im-pro-at/DIYsmarthome/README.md

# DIYsmarthome
Cheap DIY smart home system

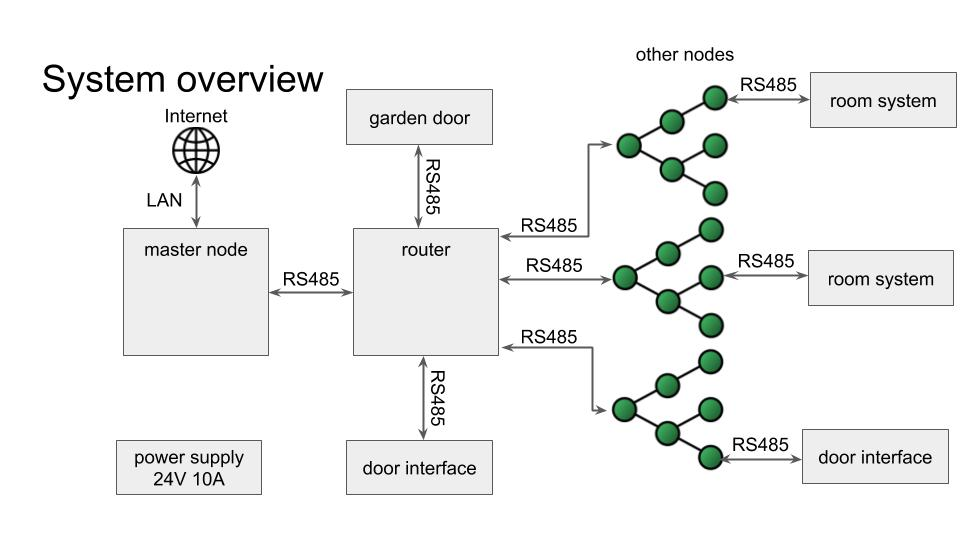
[picture p1: images/system_overview.jpg]
System overview
