im-pro-at/DIYsmarthome/PCB/room/ESP32_PINMAP.md

| PIN WROVER | GPIO | NODE | ESP32 FUNCTION | OV2640 | MAX14830 | WM8974 | I2C  |
| --- | ---- | --- | --- | --- | --- | --- | ---- |
| 25 | 0 | BOOT MODE | BOOT MODE | | | | SDC  |
| 35 | 1 | OUTPUT AT BOOT | U0TX | | | DACDAT | |
| 24 | 2 | LOW BOOT | | SIOC | | | |
| 34 | 3 | OUTPUT AT BOOT | U0RX | | | BCLK | |
| 26 | 4 | | | | | FRAME  | |
| 29 | 5 | OUTPUT AT BOOT | | | CS | | |
| 20 | 6 | FLSCH | SCK | | | | |
| 21 | 7 | FLSCH | SDO | | | | |
| 22 | 8 | FLSCH | SDI | | | | |
| 17 | 9 | FLSCH | SD2 | | | | |
| 18 | 10 | FLSCH | SD3 | | | | |
| 19 | 11 | FLSCH | CMD | | | | |
| 14 | 12 | LOW BOOT | JTAG | Y3 | | | |
| 16 | 13 | | JTAG | Y4 | | | |
| 13 | 14 | OUTPUT AT BOOT | JTAG | Y2 | | | |
| 23 | 15 | OUTPUT AT BOOT | JTAG | Y5 | | | |
| 30 | 18 | | | | SCLK | | |
| 31 | 19 | | | | MISO | | |
| 33 | 21 | | | | IRQ | | |
| 36 | 22 | | | PCLK | | | |
| 37 | 23 | | | | MOSI | | |
| 10 | 25 | | | VSNC | | | |
| 11 | 26 | | | SIOD | | | |
| 12 | 27 | | | HREF | | | |
| 8 | 32 | | | | | ADCDAT | |
| 9 | 33 | | | | | | SDA  |
| 6 | 34 | INPUT | | Y6 | | | |
| 7 | 35 | INPUT | | Y7 | | | |
| 4 | 36 | INPUT | SENSOR_VP | Y9 | | | |
| 5 | 39 | INPUT | SENSOR_VN | Y8 | | | |
| 3 | | | EN | | | | |
| 1 | | | GND | | | | |
| 2 | | | 3V3 | | | | |
| 15 | | | GND | | | | |
| 27 | | | NC | | | | |
| 28 | | | NC | | | | |
| 32 | | | NC | | | | |
| 38 | | | GND | | | | |
