im-pro-at/DIYsmarthome/PCB/master/BOM.md

| # | Deschription | Mfr. Part | Supplier | Unit Cost | Total |
| :-: | --- | --- | --- | ---: | ----: |
| 1 | PCB | [JLCPCB](https://jlcpcb.com/quote) | jlcpcb | 2 | 2 |
| 1 | Raspberry Pi 3 Modell B+ | 1690-1000-ND | Digi-Key | 35.50  | 35.50 |
| 1 | Header 40 Pol | [DS1023-2*20SF11](<https://lcsc.com/search?q=DS1023-2*20SF11>) | Lcsc | 0.25 | 0.25 |
| 1 | SanDisk Ultra 16GB Class 10 | [SDSQUAR-016G](https://www.amazon.de/SanDisk-Ultra-microSDHC-Speicherkarte-Adapter/dp/B073S9SFK2/) | Amazon | 6.99  | 6.99 |
| 1 | SPI to UART | [MAX14830](https://octopart.com/search?q=MAX14830) | Digi-Key | 11.39 | 11.39 |
| 4 | RS485 | [SN65HVD11DR](https://octopart.com/search?q=SN65HVD11DR) | Lcsc, Digi-Key | 0.53 | 2.12 |
| 4 | ESD prodection | [CDSOT23-0502B](https://lcsc.com/product-detail/Diodes-ESD_Yenji-Elec-CDSOT23-0502B_C252429.html) |  |  |  |
| 1 | supply 2A | [LMR16020](https://octopart.com/search?q=LMR16020) | Lcsc, Digi-Key | 1.01 | 1.01 |
| 4 | terminal | [WJ500V-5.08-3P](https://octopart.com/search?q=WJ500V-5.08-3P) | Lcsc | 0.12 | 0.48 |
| 2 | 47uF 35V 5x5.8 | EEEFT1V470AR | Lcsc |  |  |
| 10 | 100nF 50V X7R 0805 | CL21B104KBCNNNC | Lcsc |  |  |
| 1 | Inductor 10uH 3.9A 39.6mOhm | 1217AS-H-100M=P3 |  |  |  |
| 4 | Res 120R 1206 |  |  |  |  |
| 1 | Res 12k 1206 |  |  |  |  |
| 8 | Res 1k 1206 |  |  |  |  |
| 2 | 1uF 16V X7R 0805 | CL21B105KOFNNNE |  |  |  |
| 2 | 2.2uF 50V X7R 1206 | CL31B225KBHNNNE |  |  |  |
| 1 | fuse | 40012000000 |  |  |  |
| 1 | Res 41.2k 1206 |  |  |  |  |
| 2 | 47uF 10V X5R 1210 | CL32A476MPJNNNE |  |  |  |
| 2 | Res 4.7k 1206 |  |  |  |  |
| 1 | Res 68k 1206 |  |  |  |  |
| 1 | Schottky 60V 3A SMB | B360B-13-F |  |  |  |
| 1 | Schottky 60V 2A SMB | B260-13-F |  |  |  |
| 1 | Varistor 320V 400A | B72205S0251K101 |  |  |  |
|  1 | Oscillator 12Mhz | X1G004171001800 | | | |
