im-pro-at/DIYsmarthome/PCB/room/BOM.md

| # | Deschription | Mfr. Part | Supplier | Unit Cost [€] | Total [€] |
| :-: | :--- | --- | --- | ---: | ----: |
| 2 | PCB | [JLCPCB](https://jlcpcb.com/quote) | JLCPCB | 2.50 | 5.00 |
| 1  | ESP32 + PSRAM | [ESP32-WROVER](https://octopart.com/search?q=ESP32-WROVER) | Lcsc, Digi-Key | 3.97 | 3.97 |
| 1 | 12MHz OX SMD-2520_4P | X1G004171001800 or SG-210STF 12.0000ML3 |  |  |  |
| 3 | Optocopler | [SFH6206-3T](https://octopart.com/search?q=SFH6206-3T) | Lcsc, Digi-Key | 0.29 | 0.89 |
| 3  | Solid State Relay  | G3MC-202P DC24 | Digi-Key | 6.79	 | 20.37 |
| 1  | temperatur, humidity and pressure | [BME280](https://octopart.com/search?q=BME280) | Lcsc, Digi-Key | 2.97  | 2.97 |
| 1  | air quality | [CCS811B-JOPD500](https://octopart.com/search?q=CCS811) | Lcsc, Digi-Key | 7.55 | 7.55 |
| 1  | audio codec | [WM8974](https://octopart.com/search?q=WM8974) | Lcsc, Digi-Key | 1.74 | 1.74 |
| 1  | mic | [B4013AM423-008](https://lcsc.com/search?q=B4013AM423-008) | Lcsc | 0.15 | 0.15 |
| 1  | speaker | [SMS-2008MS-R](https://octopart.com/search?q=SMS-2008MS-R) | Digi-Key | 4.80	 | 4.80	 |
| 1  | ambient light sensor | [BH1750FVI](https://octopart.com/search?q=BH1750FVI) | Lcsc, Digi-Key | 0.80 | 0.80 |
| 1  | PIR sensor | [AS312](https://lcsc.com/search?q=AS312) | Lcsc | 0.81 | 0.81 |
| 1  | PIR sensor case | [S9008](https://lcsc.com/search?q=S9008) | Lcsc | 0.07 | 0.07 |
| 1  | vibration detection | [ADXL345BCCZ](https://octopart.com/search?q=ADXL345BCCZ) | Lcsc, Digi-Key | 1.69 | 1.69 |
| 1  | Camera | [OV2640](https://www.banggood.com/Mini-OV7670-OV2640-OV5640-AF-Camera-Module-CMOS-Image-Sensor-Module-for-Arduino-p-1444381.html?ID=6122349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) / HDF3M-811  | Banggood | 3.23 | 3.23 |
| 2  | Camera connector | [FH34SRJ-24S-0.5SH(50)](https://octopart.com/search?q=FH34SRJ-24S-0.5SH(50)) | Lcsc | 0.25 | 0.25 |
| 1 | SPI to UART | [MAX14830](https://octopart.com/search?q=MAX14830) | Digi-Key | 11.39 | 11.39 |
| 4 | RS485 | [SN65HVD11DR](https://octopart.com/search?q=SN65HVD11DR) | Lcsc, Digi-Key | 0.53 | 1.59 |
| 4 | ESD prodection | CDSOT23-0502B |  |  |  |
| | supply 1A | [LMR16010](https://octopart.com/search?q=LMR16010) | Lcsc, Digi-Key | 1.02 | 1.02 |
| 1 | supply 2A | [LMR16020](https://octopart.com/search?q=LMR16020) | Lcsc, Digi-Key | 1.01 | 1.01 |
| 2 | LDO 400 mA Adjustable Output | [RT9043GB](https://lcsc.com/product-detail/Low-Dropout-Regulators-LDO_RT9043GB_C55019.html) |  |  |  |
| 2 | interboard connector | [95278-101A14LF](https://octopart.com/search?q=95278-101A14LF) | Lcsc, Digi-Key | 0.81 | 1.62 |
| 2 | interboard connector | [XG4H-1431](https://octopart.com/search?q=XG4H-1431) | Lcsc, Digi-Key | 0.44 | 0.88 |
| 1  | address dipswitch | [DHN-08F-T-V-T/R](https://octopart.com/search?q=DHN-08F-T-V-T/R) | Lcsc | 0.87 | 0.87 |
| | terminal | [WJ500V-5.08-2P](https://octopart.com/search?q=WJ500V-5.08-2P) | Lcsc | 0.08 | 0.16 |
| 4  | terminal | [WJ500V-5.08-3P](https://octopart.com/search?q=WJ500V-5.08-3P) | Lcsc | 0.12 | 0.24 |
| 4  | terminal | [WJ142R-5.08-2P](https://octopart.com/search?q=WJ142R-5.08-2P) | Lcsc | 0.12 | 0.24 |
| | terminal | [WJ142R-5.08-3P](https://octopart.com/search?q=WJ142R-5.08-3P) | Lcsc | 0.18 | 0.36 |
| 4 | Res 120R 1206 |  |  |  |  |
| 7 | Res 10k 1206 |  |  |  |  |
| 1 | Res 608R 1206 |  |  |  |  |
| 1 | Res 68k 1206 |  |  |  |  |
| 2 | Res 12k 1206 |  |  |  |  |
| 2 | Res 33k 1206 |  |  |  |  |
| 6 | Res 100k 1206 | | | | |
| 6 | Res 100k 0.5W 2010 | | | | |
| 8 | Res 4.7k 1206 | | | | |
| 1 | Res 47k 1206 | | | | |
| 10 | Res 1k 1206 | | | | |
| 4 | Res 100R 1206 | | | | |
| 2 | 47uF 35V 5x5.8 | EEEFT1V470AR | | | |
| 1 | 220pF 50V 0805 | [CL21B221KBANNNC](https://lcsc.com/product-detail/Multilayer-Ceramic-Capacitors-MLCC-SMD-SMT_SAMSUNG_CL21B221KBANNNC_220pF-221-10-50V_C53172.html) | | | |
|  7  | 1uF 16V X7R 0805 | [CL21B105KOFNNNE](https://lcsc.com/product-detail/Multilayer-Ceramic-Capacitors-MLCC-SMD-SMT_SAMSUNG_CL21B105KOFNNNE_1uF-105-10-16V_C24123.html) | | | |
|  1  | 22uF 16V X7R 1210 | C3225X7R1C226KT000N |  |  |  |
| 2 | 47uF 10V X5R 1210 | CL32A476MPJNNNE | | | |
| 8 | 4,7uF 10V 0805 | [CL21F475ZPFNNNE](https://lcsc.com/product-detail/Multilayer-Ceramic-Capacitors-MLCC-SMD-SMT_SAMSUNG_CL21F475ZPFNNNE_4-7uF-475-80-20-10V_C50696.html) | | | |
|  20  | 100nF 50V X7R 0805 | [CL21B104KBCNNNC](https://lcsc.com/product-detail/Multilayer-Ceramic-Capacitors-MLCC-SMD-SMT_SAMSUNG_CL21B104KBCNNNC_100nF-104-10-50V_C1711.html) | | | |
| 2 | 2.2uF 50V X7R 1206 | [CL31B225KBHNNNE](https://lcsc.com/product-detail/Multilayer-Ceramic-Capacitors-MLCC-SMD-SMT_SAMSUNG_CL31B225KBHNNNE_2-2uF-225-10-50V_C50254.html) | | | |
| 4 | 2.2uF 16V 1206 | [CC1206KKX7R7BB225](https://lcsc.com/product-detail/Multilayer-Ceramic-Capacitors-MLCC-SMD-SMT_2-2uF-225-10-16V_C107183.html) | | | |
| 1 | Schottky 60V 2A SMB | [B260-13-F](https://lcsc.com/product-detail/Schottky-Barrier-Diodes-SBD_DIODES_B260-13-F_B260-13-F_C72265.html) |  |  |  |
| 1 | Schottky 60V 3A SMB | [B360B-13-F](https://lcsc.com/product-detail/Schottky-Barrier-Diodes-SBD_DIODES_B360B-13-F_B360B-13-F_C91546.html) | | | |
|  | Inductor 15uH 2.2A 56mOhm | SLF10145T-150M2R2-PF |  |  |  |
| 1 | Inductor 5.6uH 3.8A 22mOhm | [SLF10145T-5R6M3R2-PF](https://lcsc.com/product-detail/Power-Inductors_TDK_SLF10145T-5R6M3R2-PF_TDK-SLF10145T-5R6M3R2-PF_C136209.html) |  |  |  |
|  | | | | | |
| 3 | Varistor 320V 400A | B72205S0251K101 |  |  |  |
| 1 | Varistor 30V | [B72214S0300K101](https://lcsc.com/product-detail/Others_EPCOS_B72214S0300K101_EPCOS-B72214S0300K101_C210626.html) | | | |
| 4 | Fuse 2A Slow | [40012000000](https://lcsc.com/product-detail/Blade-Fuses_Littelfuse_40012000000_Littelfuse-40012000000_C178824.html) |  |  |  |
| 6 | transistor NPN 60V | [MMBTA06LT1G](https://lcsc.com/product-detail/Transistors-NPN-PNP_ON-Semicon_MMBTA06LT1G_ON-Semicon-ON-MMBTA06LT1G_C77760.html) |  |  |  |
|  | Diodo 150mA SOD-323 | [1N4148WS](https://lcsc.com/product-detail/Switching-Diode_Changjiang-Electronics-Tech-CJ-1N4148WS_C2128.html) |  |  |  |
| | | | | |  |
