im-pro-at/DIYsmarthome/PCB/order/19.04.24/room_sensors_schematic.pdf

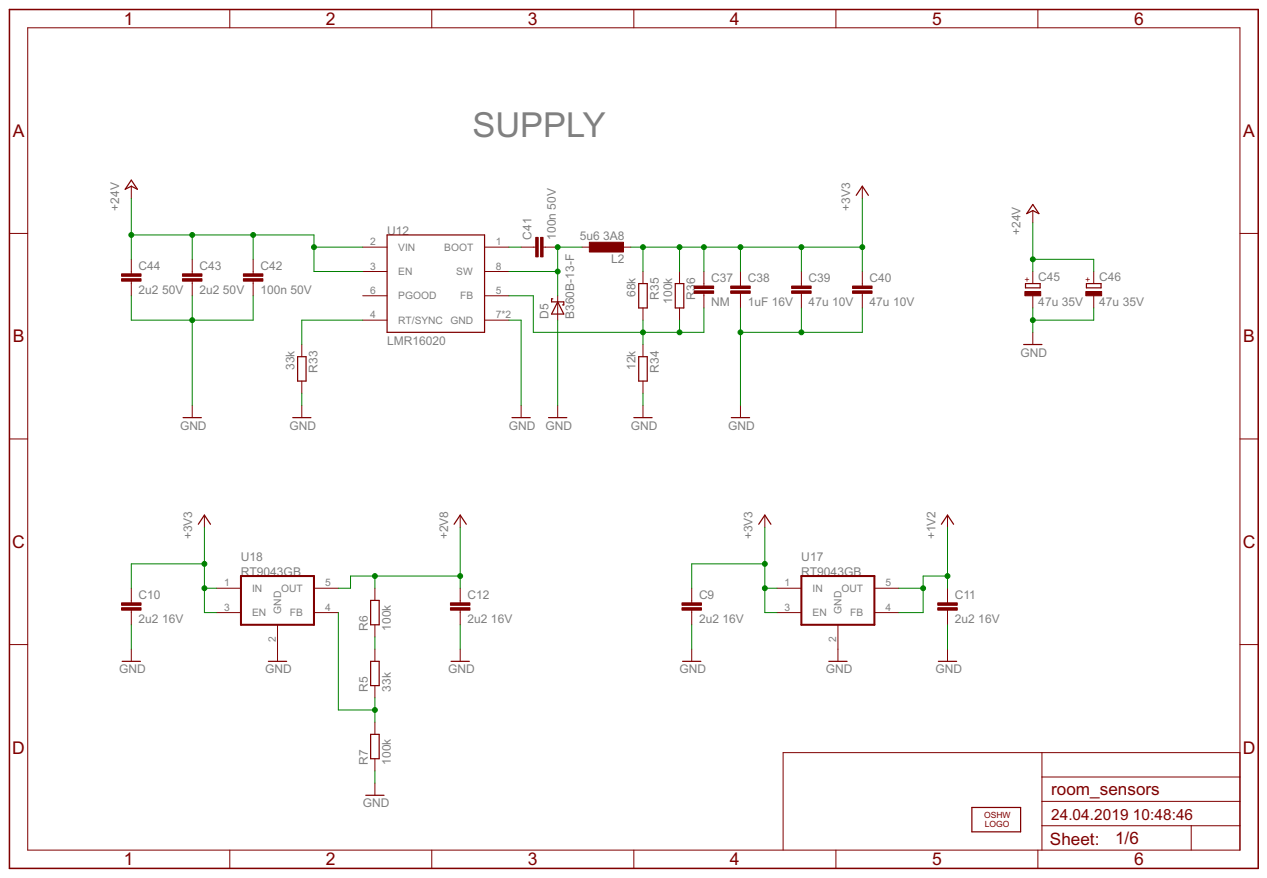
[picture p2: page 1]

+3V3 GND GND GND GND

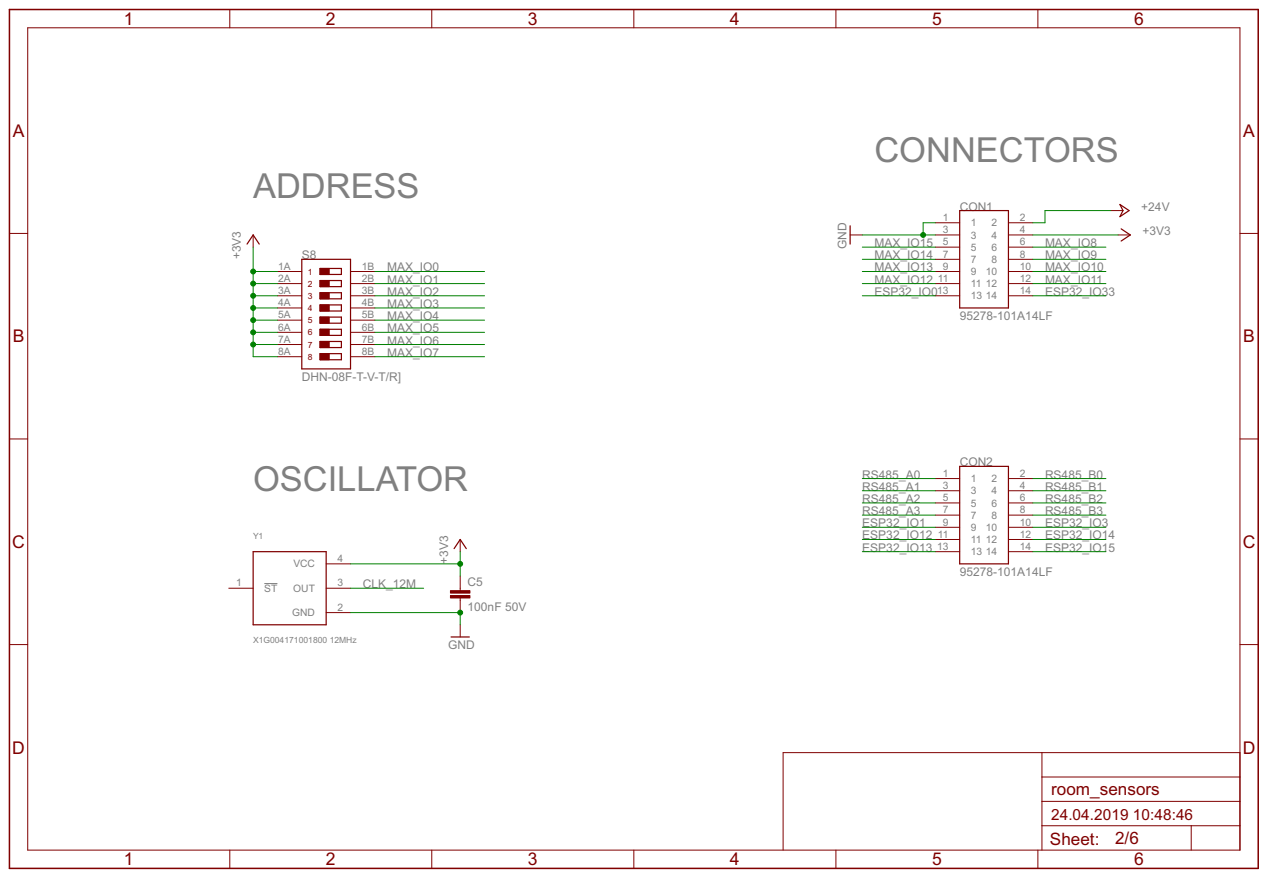
[picture p3: page 2]

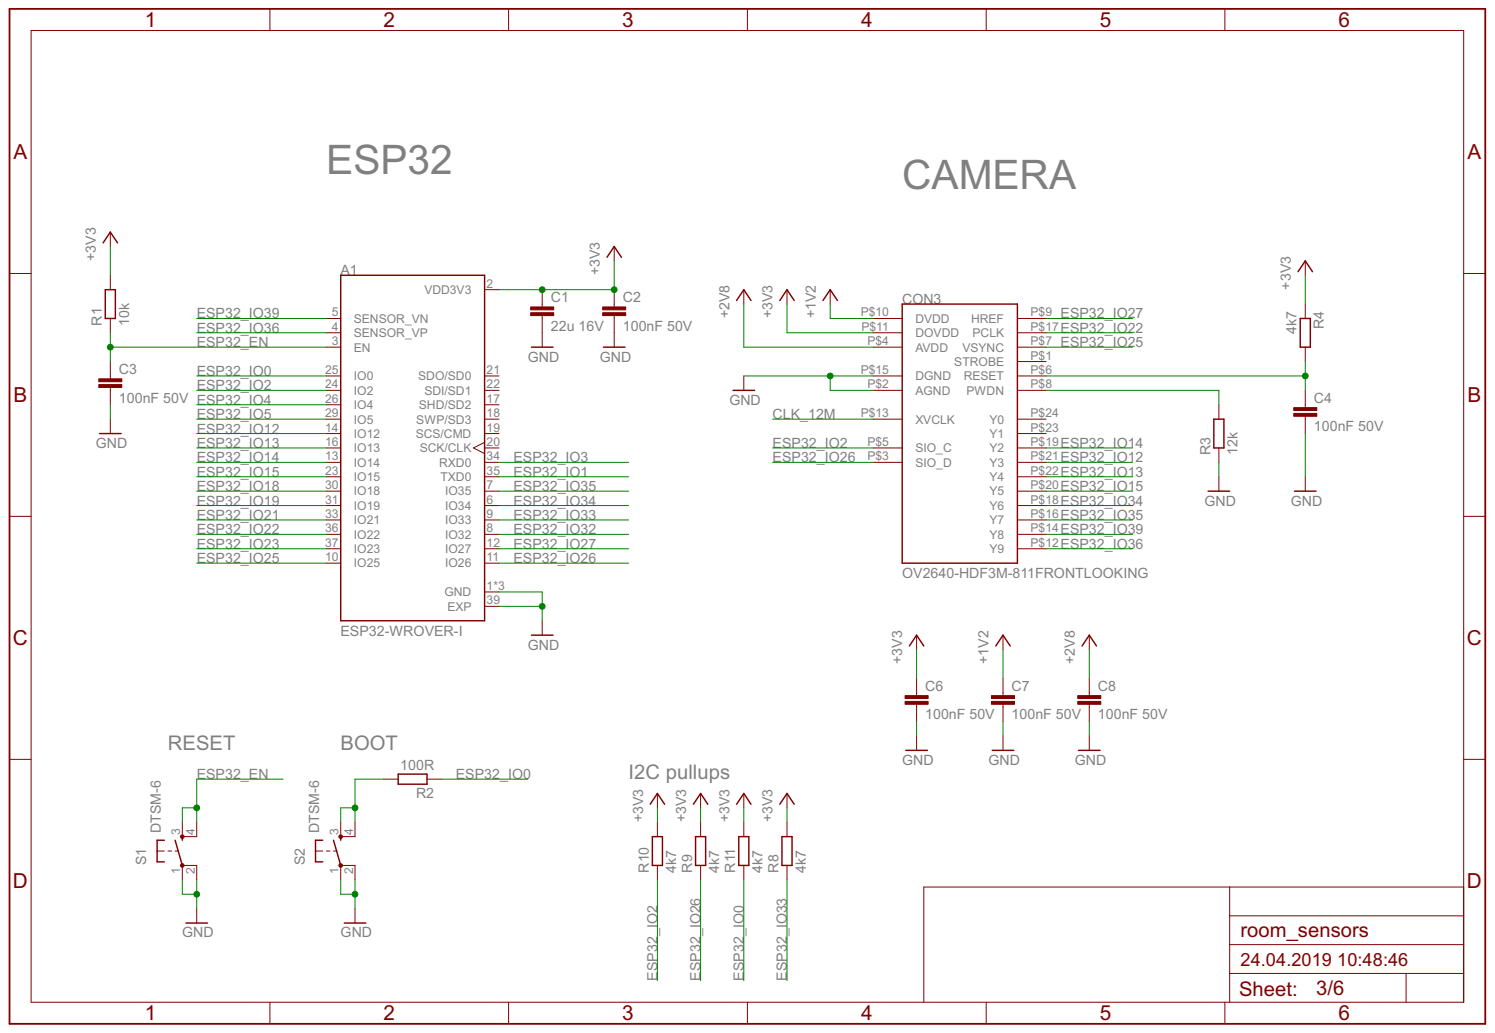
[picture p4: page 3]

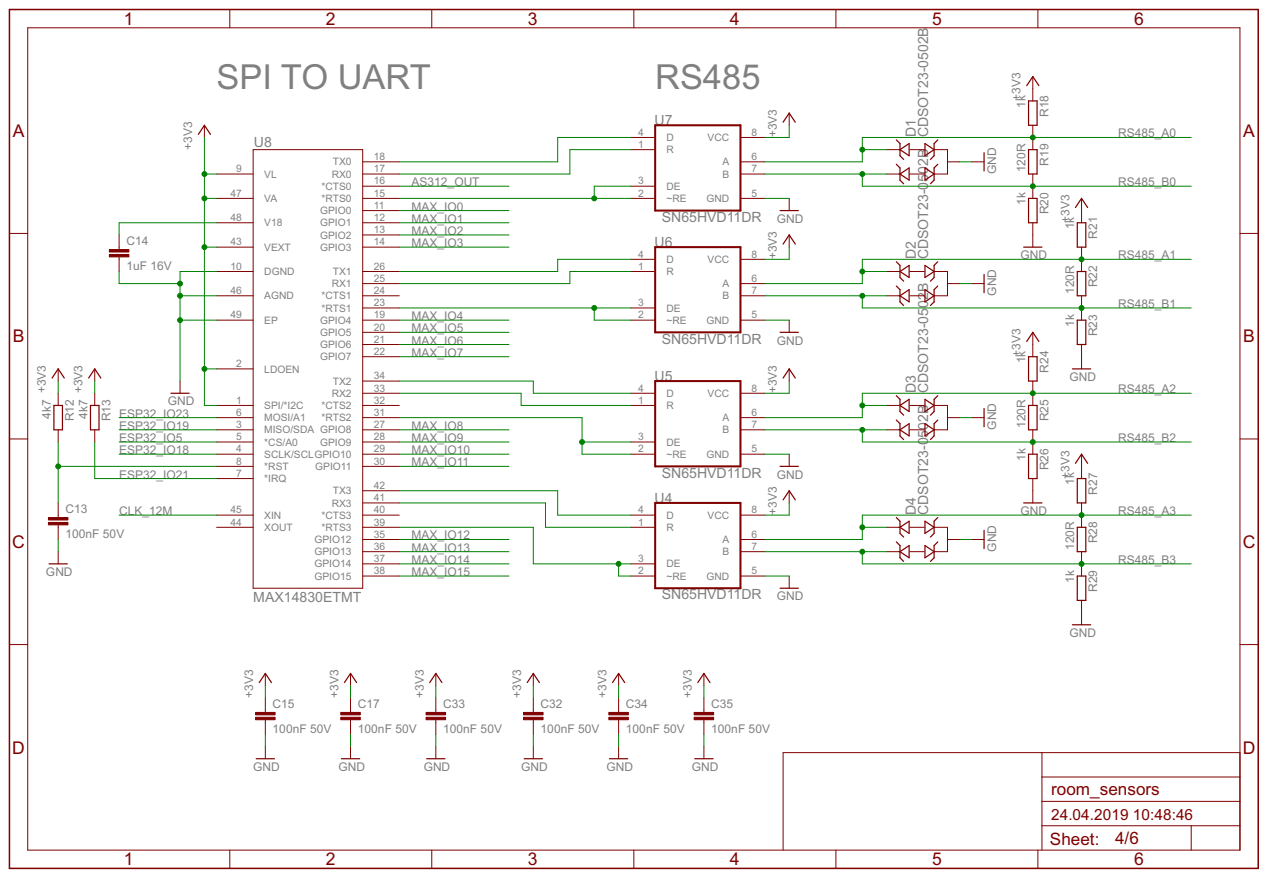
[picture p5: page 4]

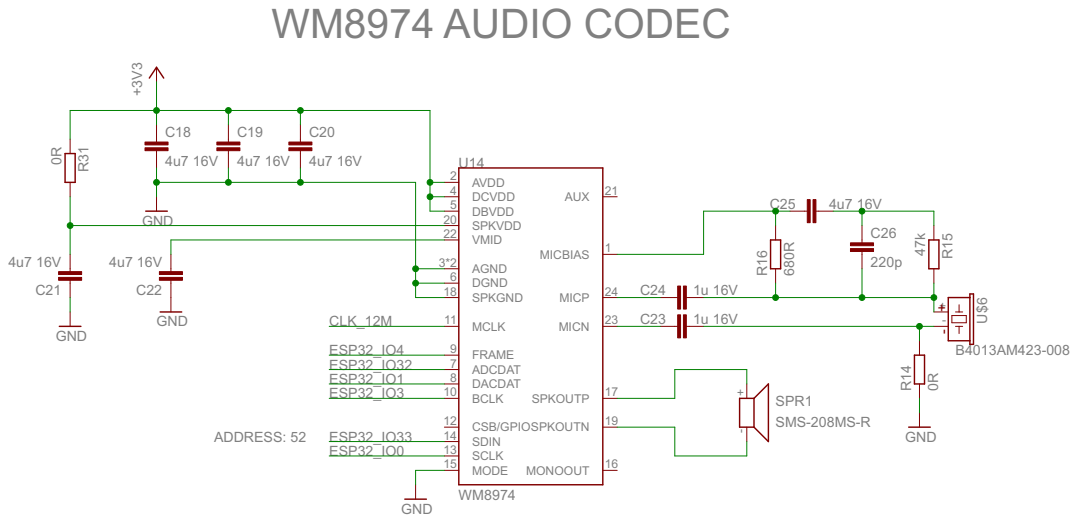
[picture p6: page 5]

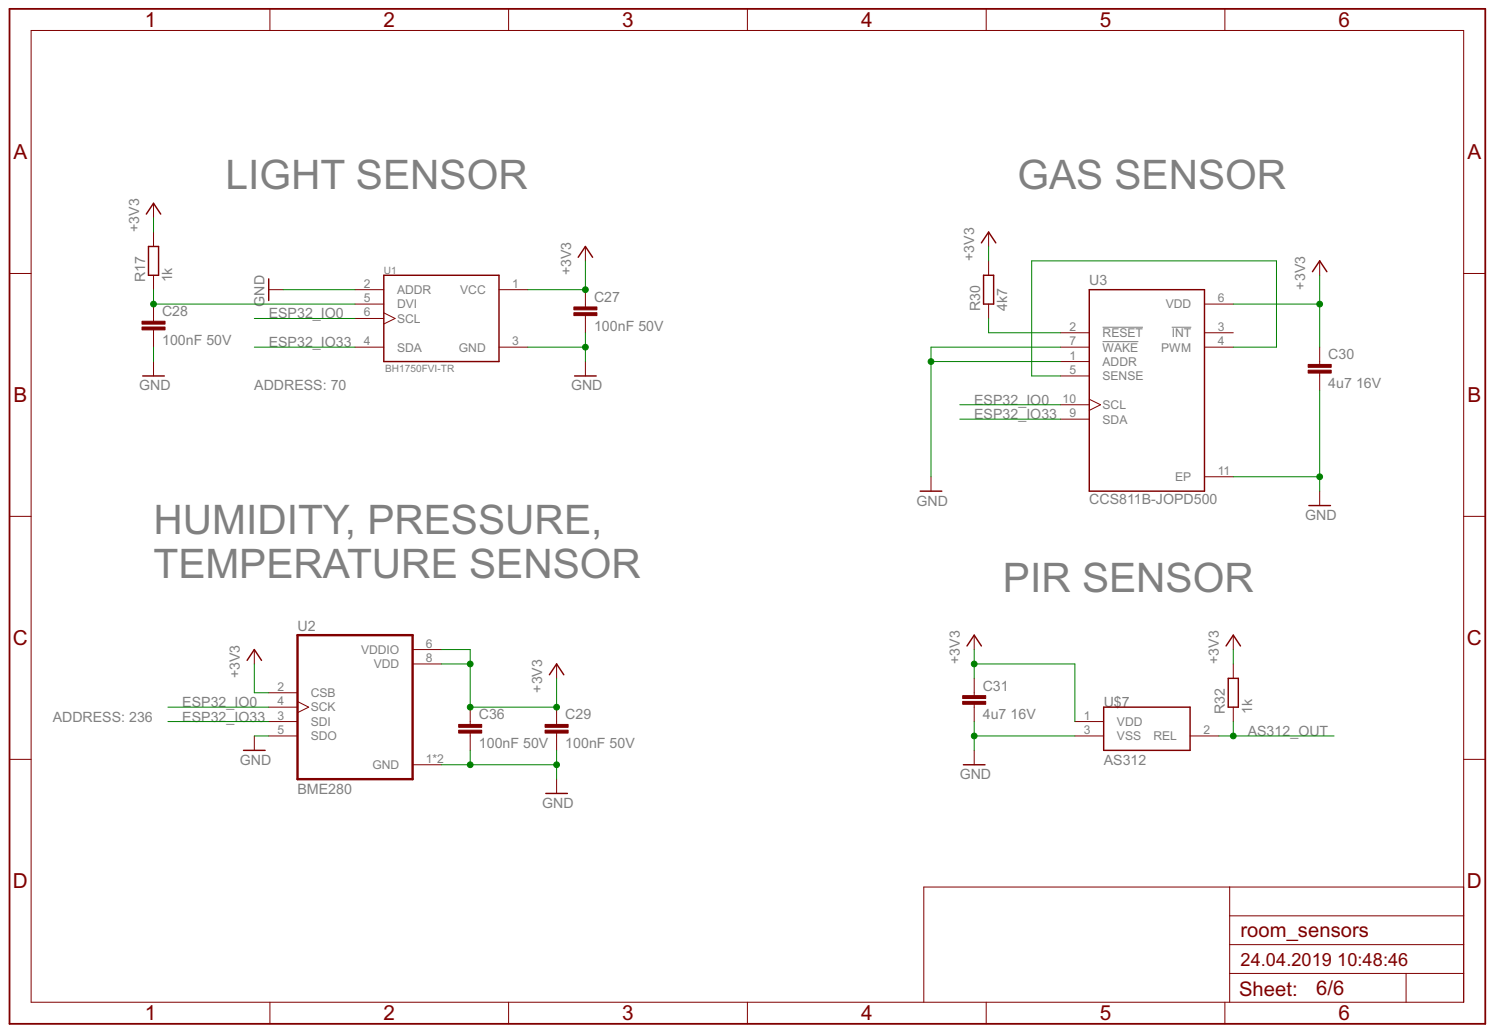
[picture p7: page 6]
