im-pro-at/DIYsmarthome/PCB/order/19.04.24/master_PCB_BOTTOM.pdf

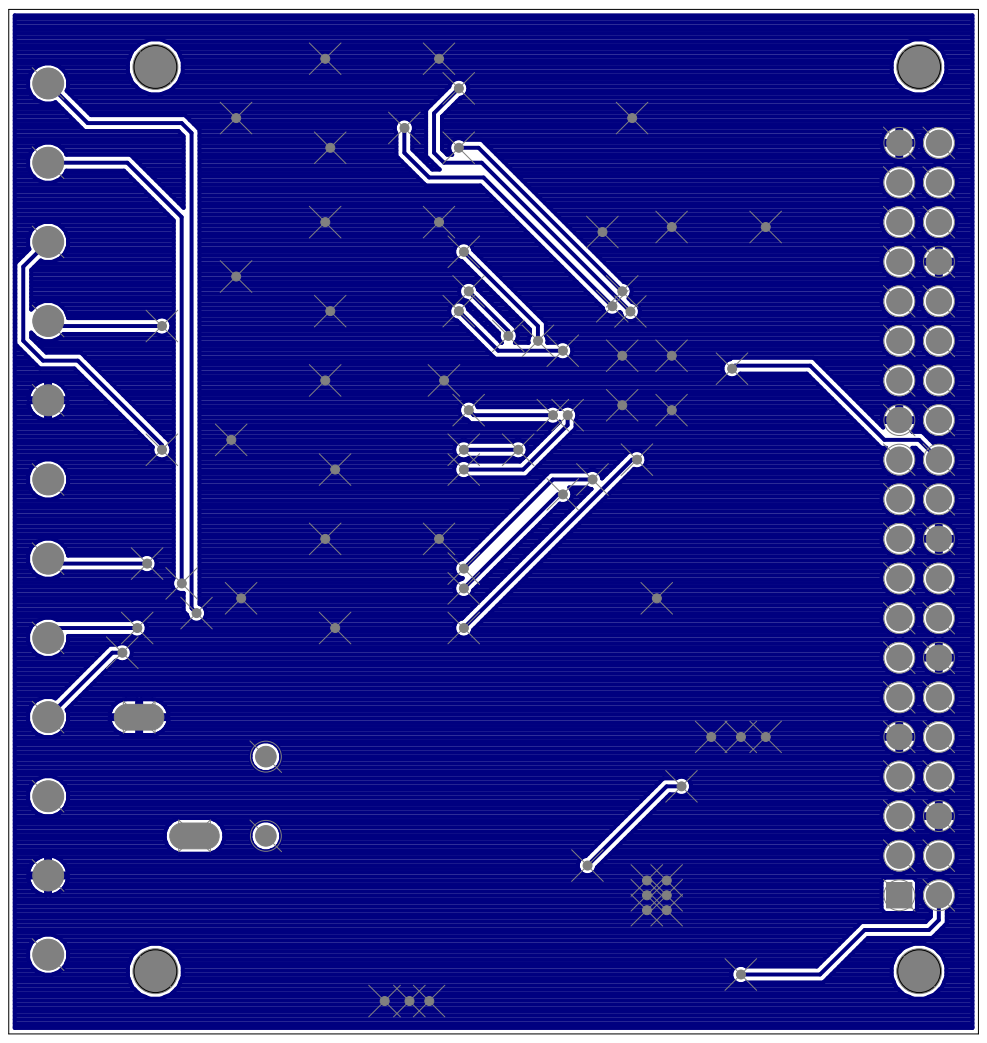
[picture p8: page 1]
