im-pro-at/DIYsmarthome/PCB/order/19.04.24/master_PCB_TOP.pdf

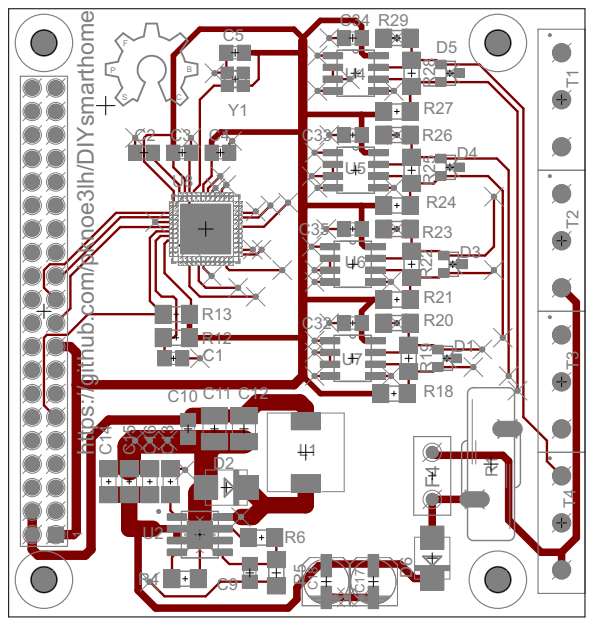
[picture p9: page 1]

https:/ github.com/pknoe3lh/DIYsmarthome 1 S P F B C U2 R4 C9 D2 C10 C11 C12 C13 C14 C15 C16 C17 C18 R5 R6L1 U8 R12 C1 R13 C2 C3 C4 D1D3 D4 D5 R18 R19 R20 R21 R22 R23 R24 R25 R26 R27R28 R29 C32 C33 C34 C35 U4U5U6 U7 Y1 C5 T4 T3 T1 T2 R1 D6 F4
