im-pro-at/DIYsmarthome/PCB/order/19.04.24/master_schematic.pdf

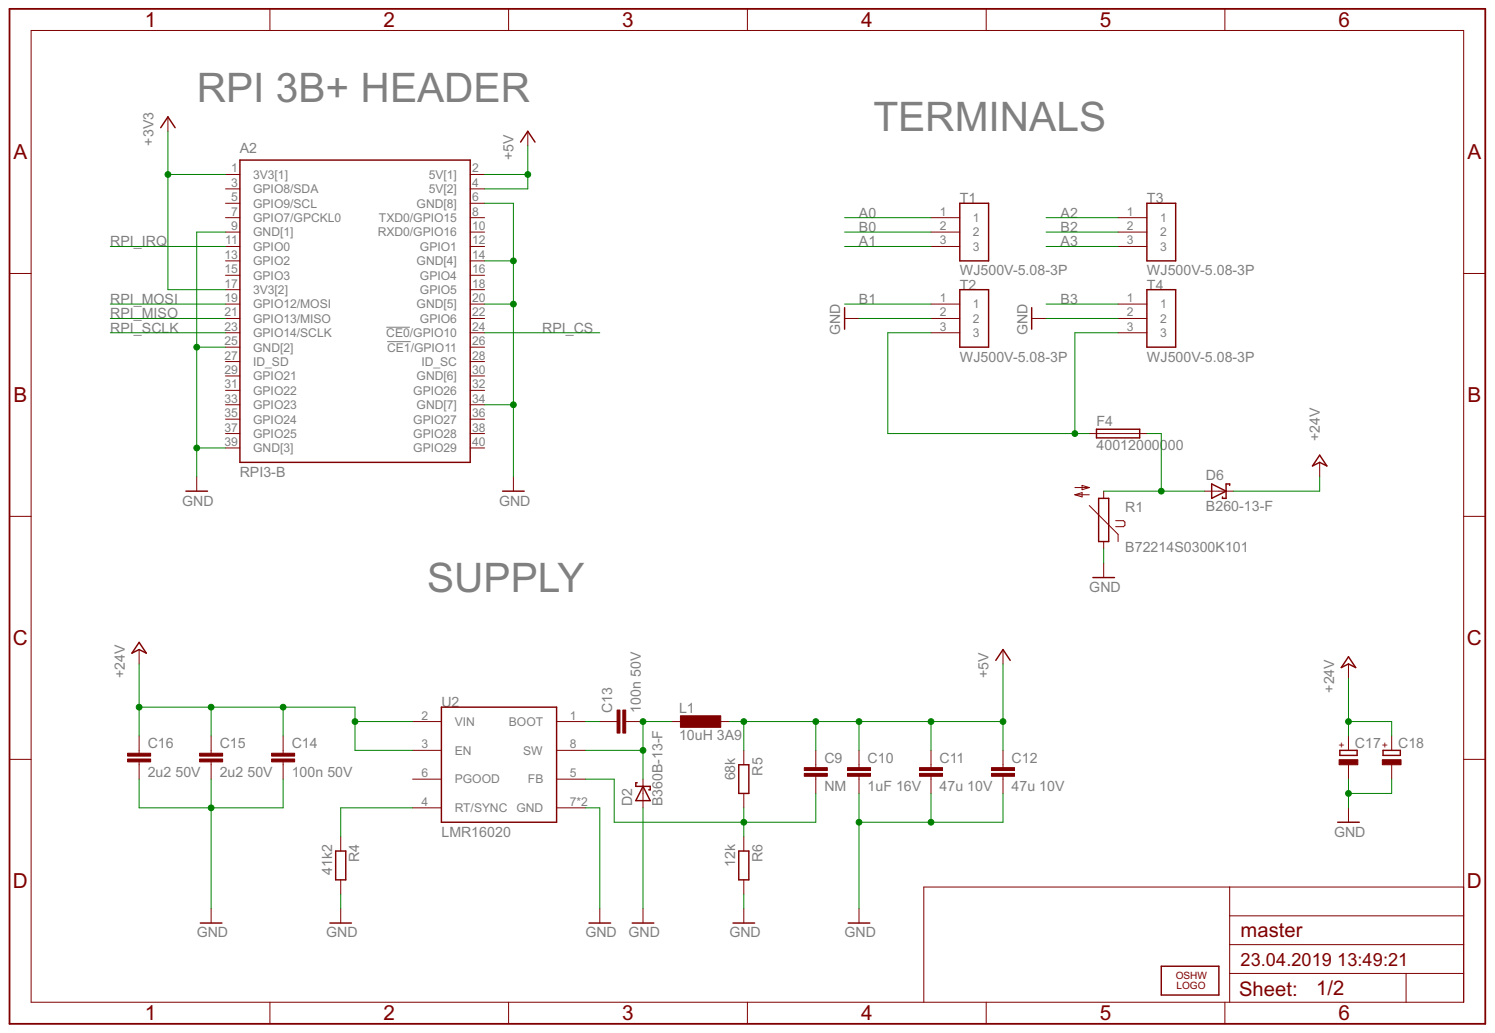
[picture p10: page 1]

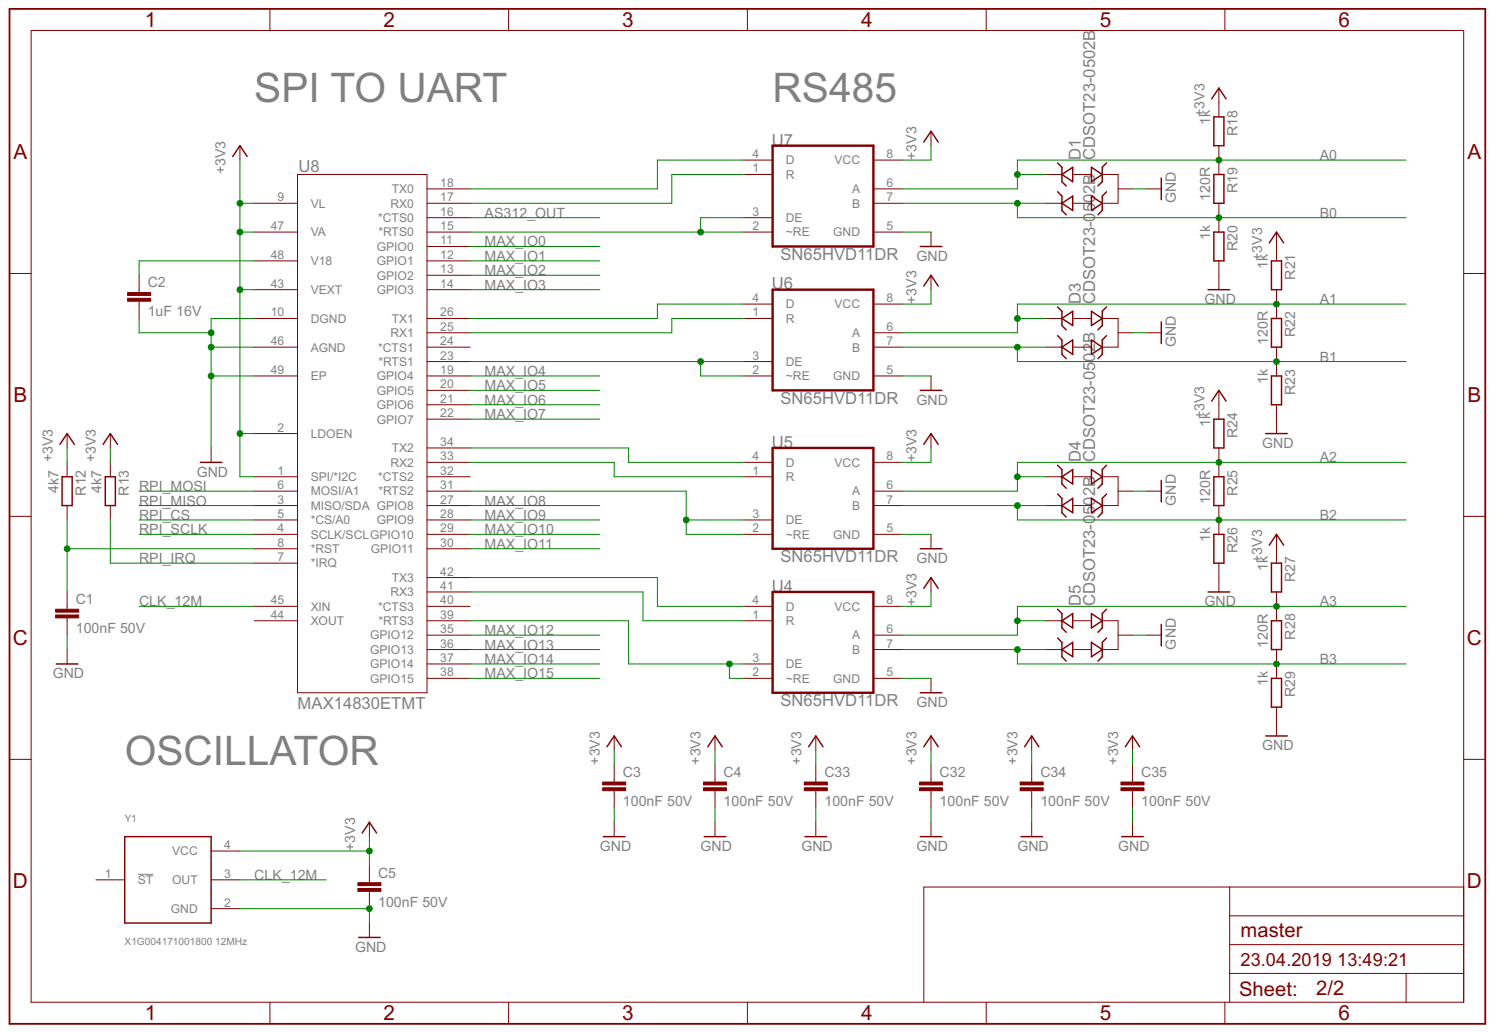
[picture p11: page 2]

48 | | 11 GPIO1 12 GPIO2 13 GPIO3
