im-pro-at/DIYsmarthome/PCB/order/19.04.24/room_interface_PCB_BOTTOM.pdf

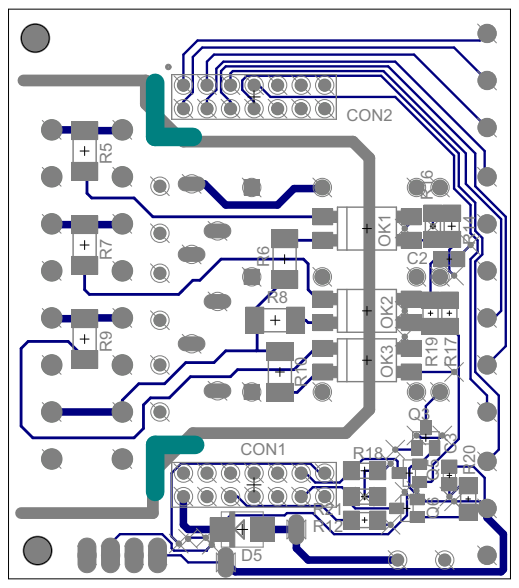
[picture p12: page 1]
