im-pro-at/DIYsmarthome/PCB/order/19.04.24/room_interface_PCB_TOP.pdf

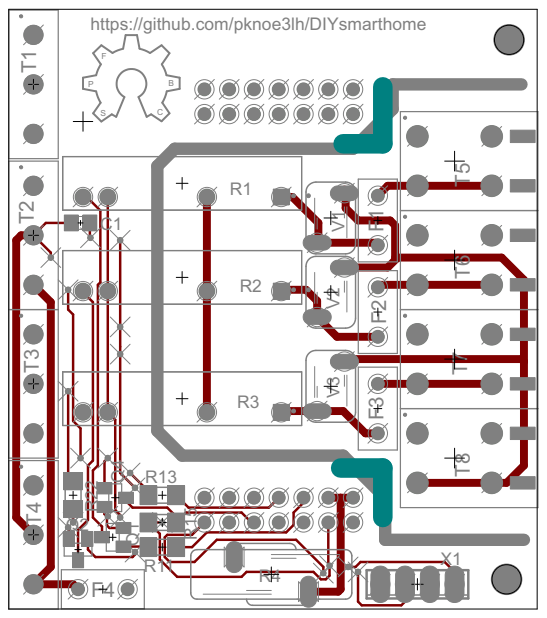
[picture p13: page 1]

https://github.com/pknoe3lh/DIYsmarthome
