im-pro-at/DIYsmarthome/PCB/order/19.04.24/room_interface_schematic.pdf

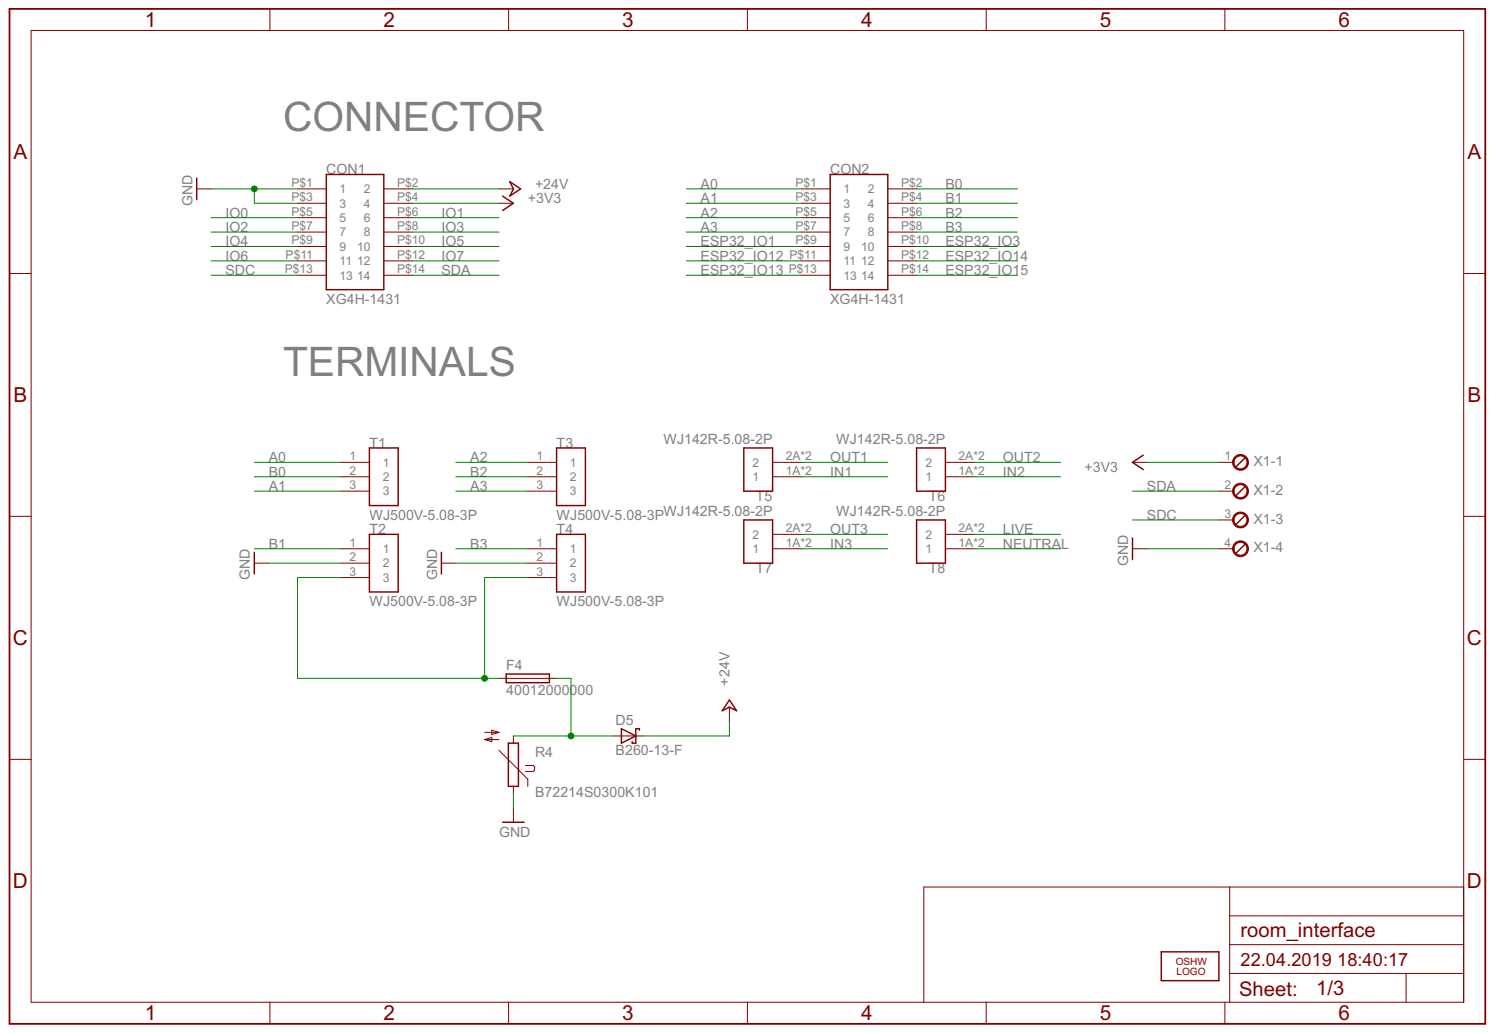
[picture p14: page 1]

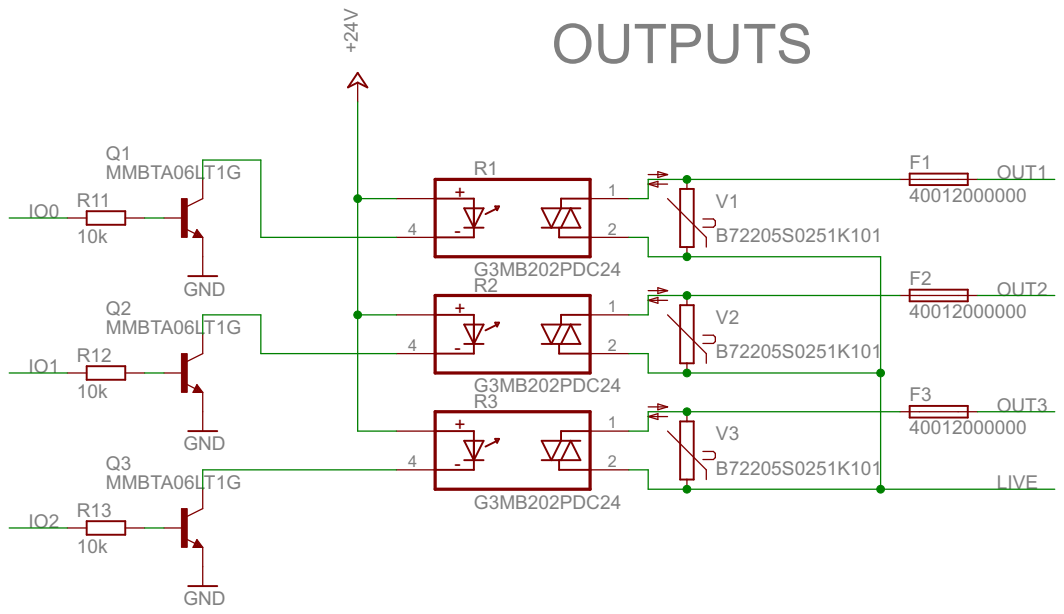
[picture p15: page 2]

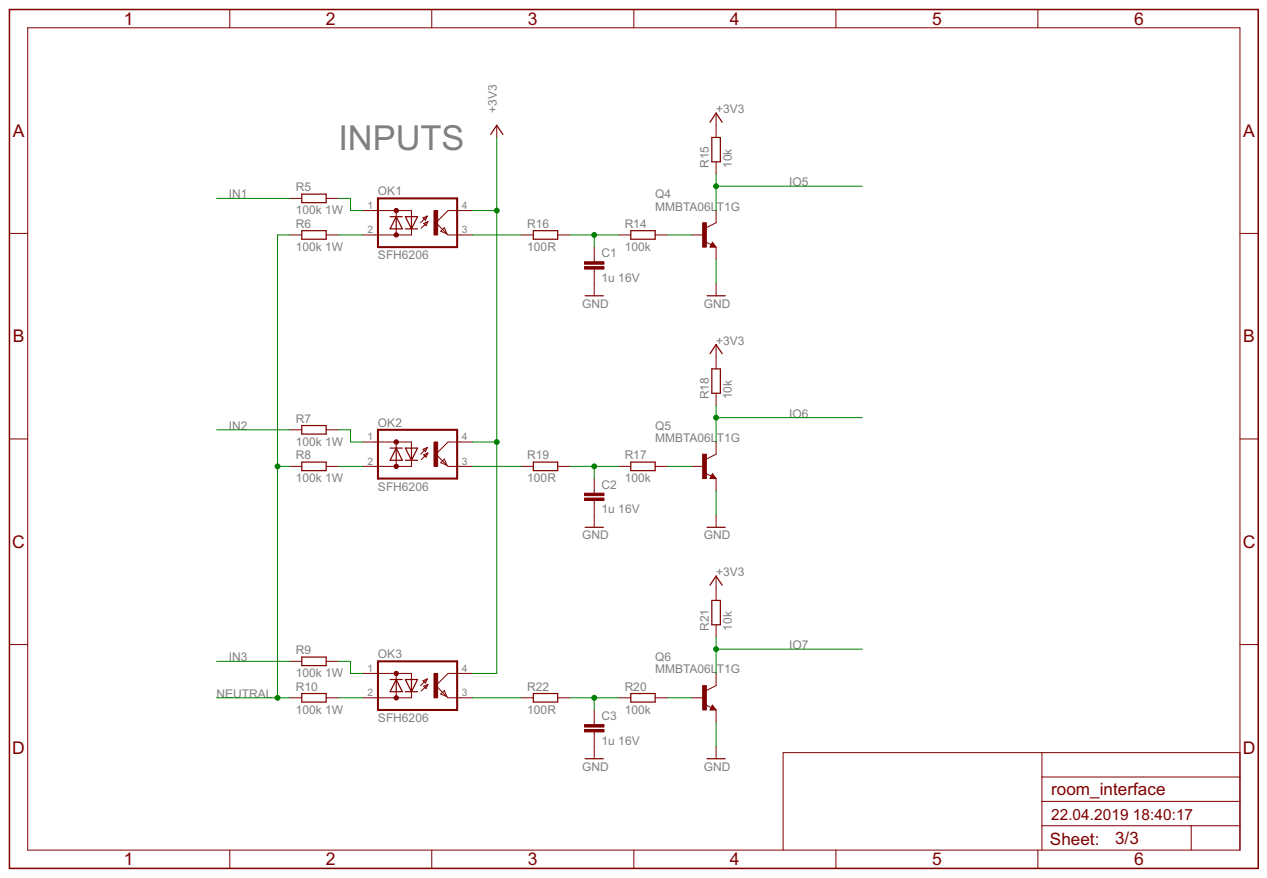
[picture p16: page 3]
