im-pro-at/DIYsmarthome/PCB/order/19.04.24/room_sensors_PCB_BOTTOM.pdf

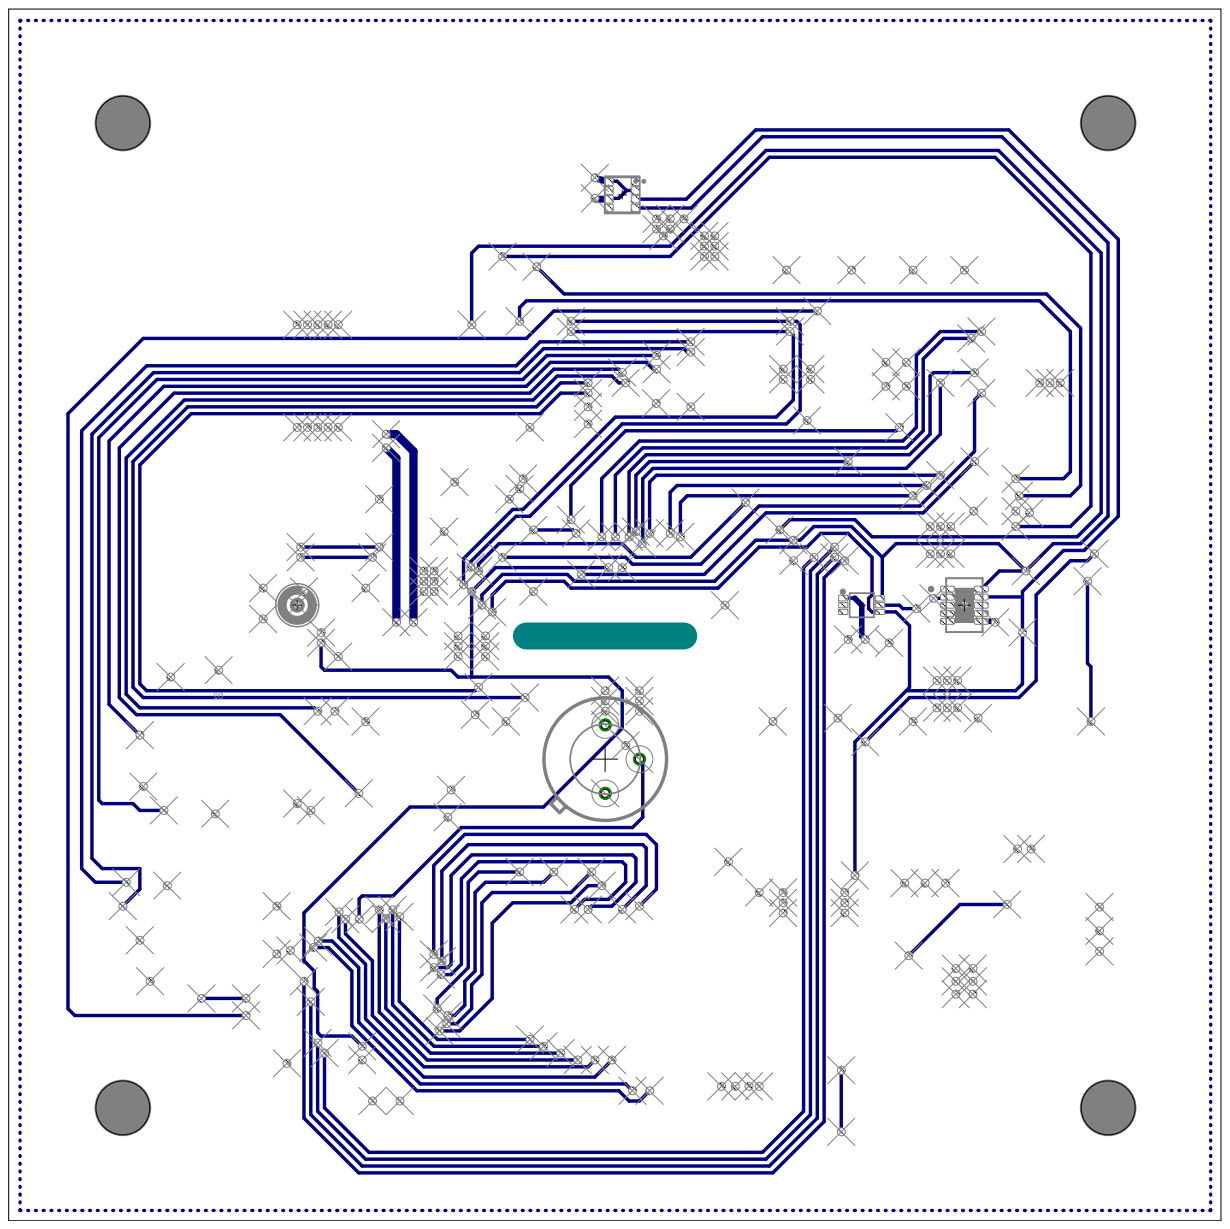
[picture p17: page 1]
