im-pro-at/DIYsmarthome/PCB/order/19.04.24/room_sensors_PCB_TOP.pdf

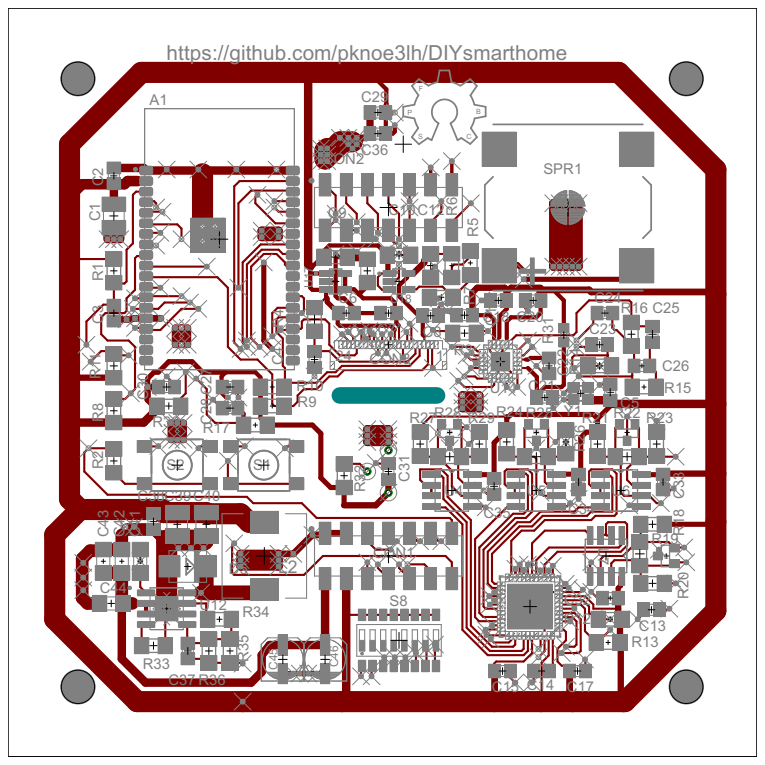
[picture p18: page 1]
