im-pro-at/DIYsmarthome/PCB/order/19.04.24/room_sensors.brd

## EAGLE design PCB/order/19.04.24/room_sensors.brd (2019-04-26)

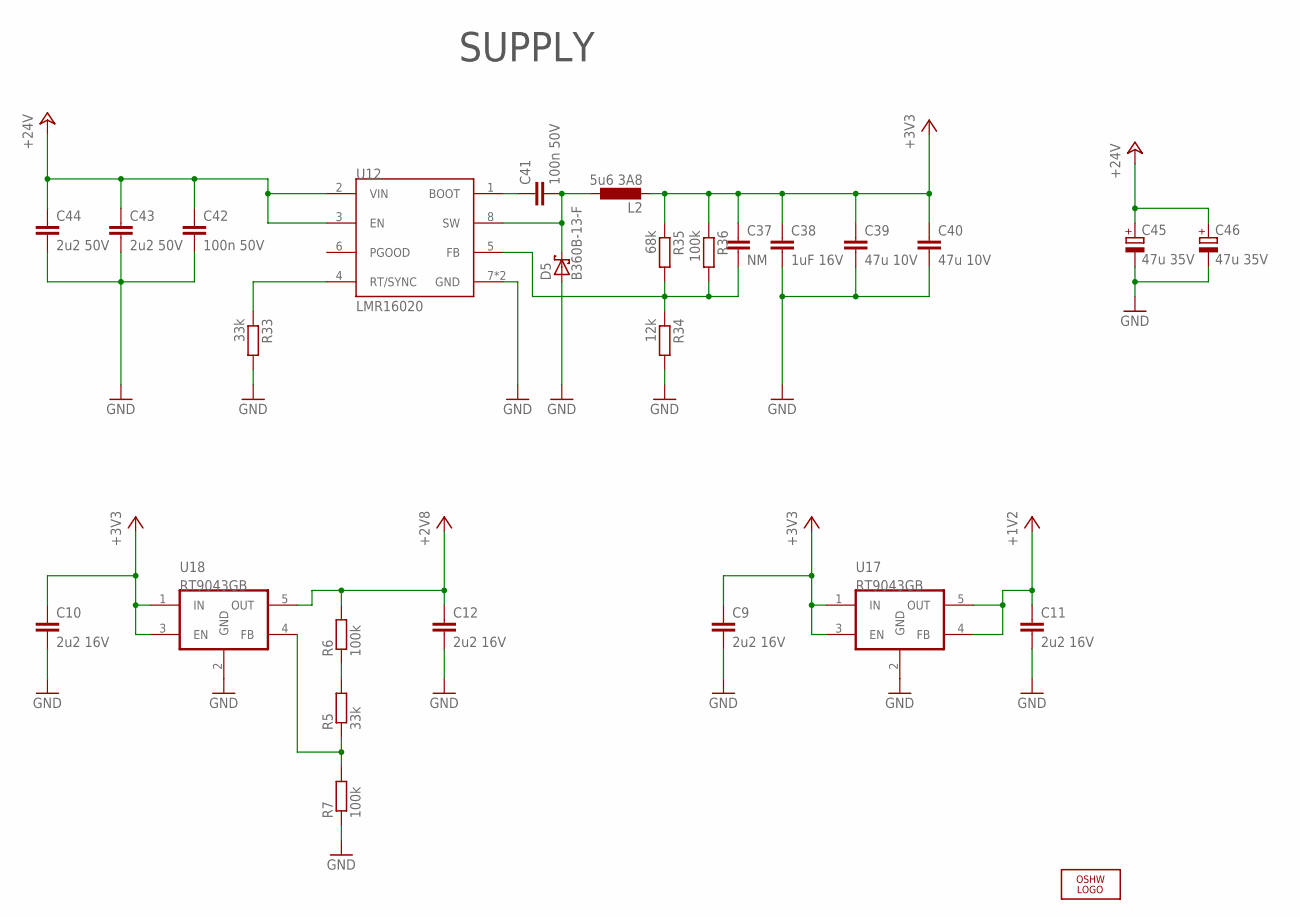
[picture p19: schematic room_sensors.sch, sheet 1]

Parts:
C9, C10, C11, C12: 2u2 16V; C1206
C37: NM; C0805
C38: 1uF 16V; C0805
C39, C40: 47u 10V; C1210
C41, C42: 100n 50V; C1206
C43, C44: 2u2 50V; C1206
C45, C46: 47u 35V; UD-5X5,8_NICHICON
D5: B360B-13-F; SMB
L2: 5u6 3A8; SLF10145T-150M2R2-PF
LOGO1: OSHW_LOGO_FILLX0350-NT; OSHW_FILLX350_NOTEXT
R5, R33: 33k; R1206
R6, R7, R36: 100k; R1206
R34: 12k; R1206
R35: 68k; R1206
U12: LMR16020; SOIC127P600X170-8N
U17, U18: RT9043GB; SOP95P275X110-5N

Connections:
+1V2: C11.1, U17.4 (FB), U17.5 (OUT); also elsewhere on the board
+2V8: C12.1, R6.2, U18.5 (OUT); also elsewhere on the board
+3V3: C9.1, C10.1, C37.1, C38.1, C39.1, C40.1, L2.P$2 (2), R35.1, R36.1, U17.1 (IN), U17.3 (EN), U18.1 (IN), U18.3 (EN); also elsewhere on the board
+24V: C42.1, C43.1, C44.1, C45.+, C46.+, U12.2 (VIN), U12.3 (EN); also elsewhere on the board
ESP32_EN1: R5.1, R7.2, U18.4 (FB)
GND: C9.2, C10.2, C11.2, C12.2, C38.2, C39.2, C40.2, C42.2, C43.2, C44.2, C45.-, C46.-, D5.A, R7.1, R33.2, R34.2, U12.7 (GND), U12.9 (GND), U17.2 (GND), U18.2 (GND); also elsewhere on the board
unnamed: R5.2, R6.1
unnamed: R33.1, U12.4 (RT/SYNC)
unnamed: C37.2, R34.1, R35.2, R36.2, U12.5 (FB)
unnamed: C41.2, D5.C, L2.P$1 (1), U12.8 (SW)
unnamed: C41.1, U12.1 (BOOT)

Notes on the sheet:
SUPPLY

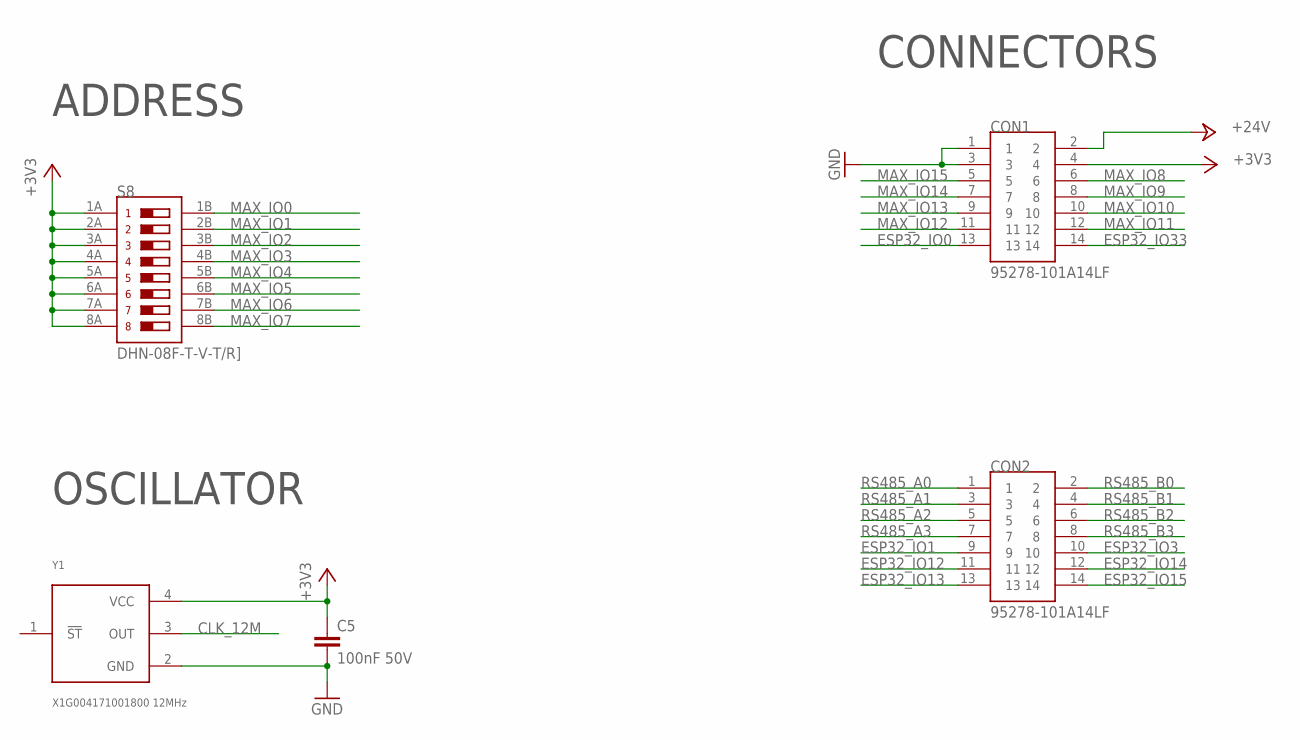
[picture p20: schematic room_sensors.sch, sheet 2]

Parts:
C5: 100nF 50V; C0805
CON1, CON2: 95278-101A14LF
S8: DHN-08F-T-V-T/R]
Y1: X1G004171001800 12MHz; OSCCC250X200X80-4N

Connections:
+3V3: C5.1, CON1.4, S8.1A, S8.2A, S8.3A, S8.4A, S8.5A, S8.6A, S8.7A, S8.8A, Y1.4 (VCC); also elsewhere on the board
+24V: CON1.2; also elsewhere on the board
CLK_12M: Y1.3 (OUT); also elsewhere on the board
ESP32_IO0: CON1.13; also elsewhere on the board
ESP32_IO1: CON2.9; also elsewhere on the board
ESP32_IO3: CON2.10; also elsewhere on the board
ESP32_IO12: CON2.11; also elsewhere on the board
ESP32_IO13: CON2.13; also elsewhere on the board
ESP32_IO14: CON2.12; also elsewhere on the board
ESP32_IO15: CON2.14; also elsewhere on the board
ESP32_IO33: CON1.14; also elsewhere on the board
GND: C5.2, CON1.1, CON1.3, Y1.2 (GND); also elsewhere on the board
MAX_IO0: S8.1B; also elsewhere on the board
MAX_IO1: S8.2B; also elsewhere on the board
MAX_IO2: S8.3B; also elsewhere on the board
MAX_IO3: S8.4B; also elsewhere on the board
MAX_IO4: S8.5B; also elsewhere on the board
MAX_IO5: S8.6B; also elsewhere on the board
MAX_IO6: S8.7B; also elsewhere on the board
MAX_IO7: S8.8B; also elsewhere on the board
MAX_IO8: CON1.6; also elsewhere on the board
MAX_IO9: CON1.8; also elsewhere on the board
MAX_IO10: CON1.10; also elsewhere on the board
MAX_IO11: CON1.12; also elsewhere on the board
MAX_IO12: CON1.11; also elsewhere on the board
MAX_IO13: CON1.9; also elsewhere on the board
MAX_IO14: CON1.7; also elsewhere on the board
MAX_IO15: CON1.5; also elsewhere on the board
RS485_A0: CON2.1; also elsewhere on the board
RS485_A1: CON2.3; also elsewhere on the board
RS485_A2: CON2.5; also elsewhere on the board
RS485_A3: CON2.7; also elsewhere on the board
RS485_B0: CON2.2; also elsewhere on the board
RS485_B1: CON2.4; also elsewhere on the board
RS485_B2: CON2.6; also elsewhere on the board
RS485_B3: CON2.8; also elsewhere on the board

Notes on the sheet:
CONNECTORS
ADDRESS
OSCILLATOR

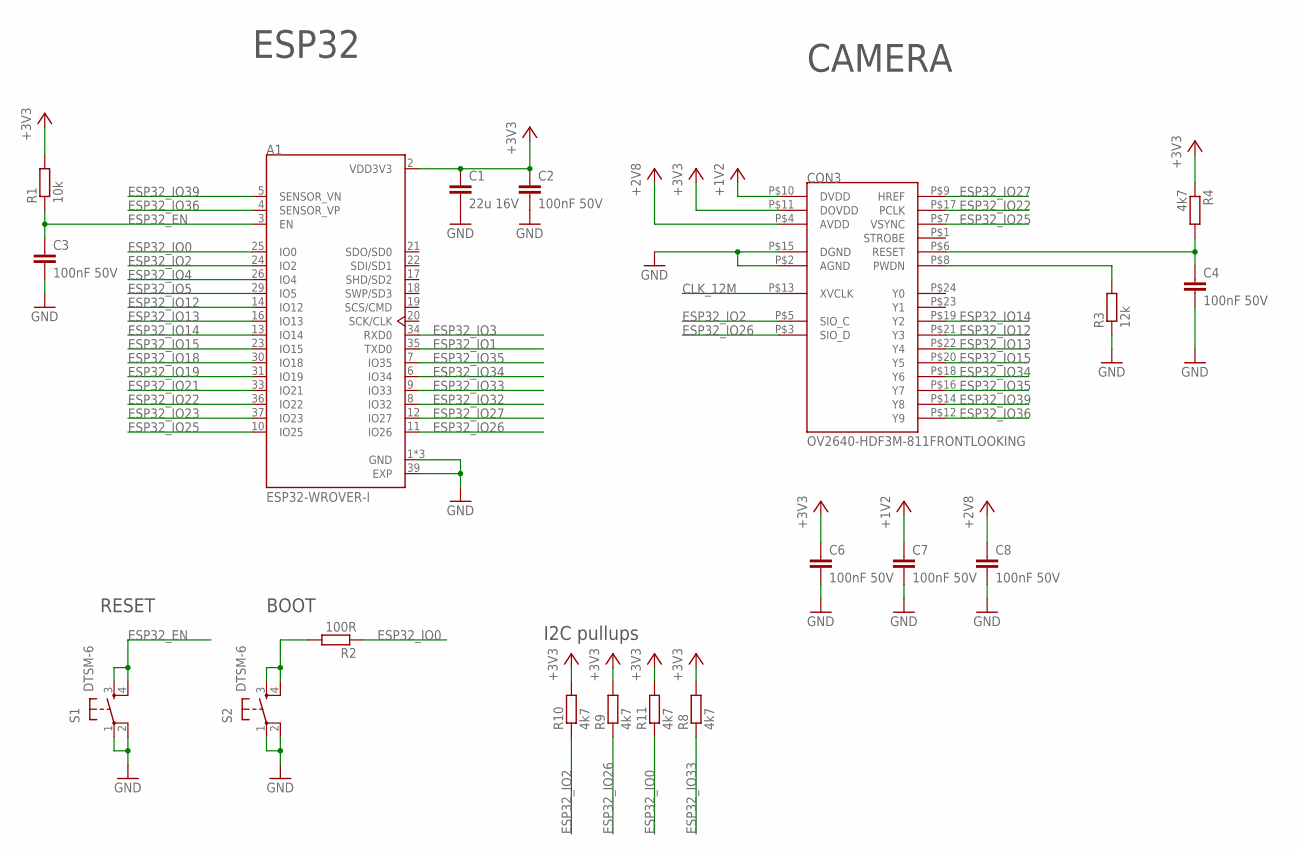
[picture p21: schematic room_sensors.sch, sheet 3]

Parts:
A1: ESP32-WROVER-I; XCVR_ESP32-WROVER-I
C1: 22u 16V; C1210
C2, C3, C4, C6, C7, C8: 100nF 50V; C0805
CON3: OV2640-HDF3M-811FRONTLOOKING; FH34SRJ-24S-0.5SH(50)
R1: 10k; R1206
R2: 100R; R1206
R3: 12k; R1206
R4, R8, R9, R10, R11: 4k7; R1206
S1, S2: DTSM-6

Connections:
+1V2: C7.1, CON3.P$10 (DVDD); also elsewhere on the board
+2V8: C8.1, CON3.P$4 (AVDD); also elsewhere on the board
+3V3: A1.2 (VDD3V3), C1.1, C2.1, C6.1, CON3.P$11 (DOVDD), R1.2, R4.1, R8.2, R9.2, R10.2, R11.2; also elsewhere on the board
CLK_12M: CON3.P$13 (XVCLK); also elsewhere on the board
ESP32_BOOT: R2.2, S2.3, S2.4
ESP32_EN: A1.3 (EN), C3.1, R1.1, S1.3, S1.4
ESP32_IO0: A1.25 (IO0), R2.1, R11.1; also elsewhere on the board
ESP32_IO1: A1.35 (TXD0); also elsewhere on the board
ESP32_IO2: A1.24 (IO2), CON3.P$5 (SIO_C), R10.1
ESP32_IO3: A1.34 (RXD0); also elsewhere on the board
ESP32_IO4: A1.26 (IO4); also elsewhere on the board
ESP32_IO5: A1.29 (IO5); also elsewhere on the board
ESP32_IO12: A1.14 (IO12), CON3.P$21 (Y3); also elsewhere on the board
ESP32_IO13: A1.16 (IO13), CON3.P$22 (Y4); also elsewhere on the board
ESP32_IO14: A1.13 (IO14), CON3.P$19 (Y2); also elsewhere on the board
ESP32_IO15: A1.23 (IO15), CON3.P$20 (Y5); also elsewhere on the board
ESP32_IO18: A1.30 (IO18); also elsewhere on the board
ESP32_IO19: A1.31 (IO19); also elsewhere on the board
ESP32_IO21: A1.33 (IO21); also elsewhere on the board
ESP32_IO22: A1.36 (IO22), CON3.P$17 (PCLK)
ESP32_IO23: A1.37 (IO23); also elsewhere on the board
ESP32_IO25: A1.10 (IO25), CON3.P$7 (VSYNC)
ESP32_IO26: A1.11 (IO26), CON3.P$3 (SIO_D), R9.1
ESP32_IO27: A1.12 (IO27), CON3.P$9 (HREF)
ESP32_IO32: A1.8 (IO32); also elsewhere on the board
ESP32_IO33: A1.9 (IO33), R8.1; also elsewhere on the board
ESP32_IO34: A1.6 (IO34), CON3.P$18 (Y6)
ESP32_IO35: A1.7 (IO35), CON3.P$16 (Y7)
ESP32_IO36: A1.4 (SENSOR_VP), CON3.P$12 (Y9)
ESP32_IO39: A1.5 (SENSOR_VN), CON3.P$14 (Y8)
GND: A1.1 (GND), A1.15 (GND), A1.38 (GND), A1.39 (EXP), C1.2, C2.2, C3.2, C4.2, C6.2, C7.2, C8.2, CON3.P$2 (AGND), CON3.P$15 (DGND), R3.1, S1.1, S1.2, S2.1, S2.2; also elsewhere on the board
unnamed: CON3.P$8 (PWDN), R3.2
unnamed: C4.1, CON3.P$6 (RESET), R4.2

Notes on the sheet:
RESET
BOOT
ESP32
CAMERA
I2C pullups

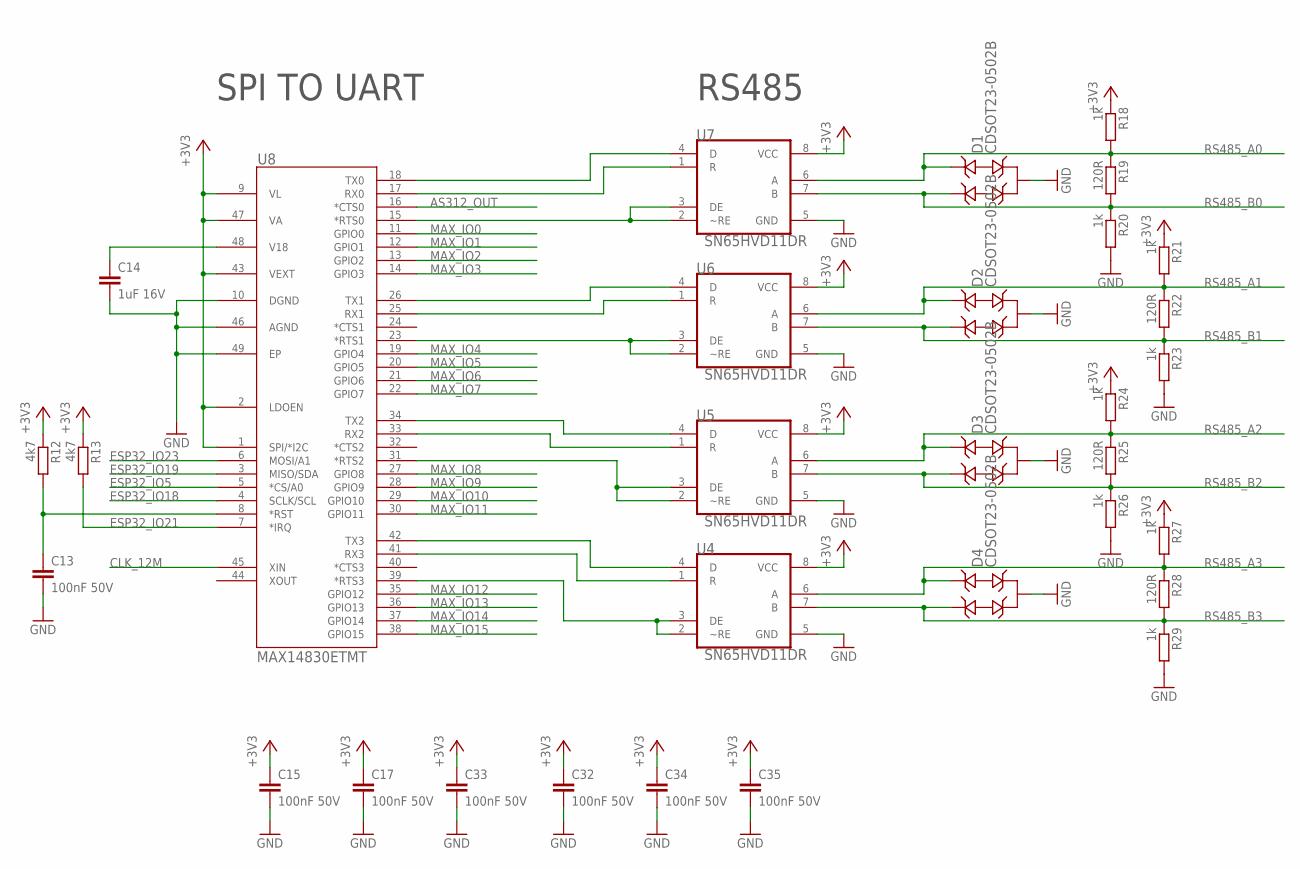
[picture p22: schematic room_sensors.sch, sheet 4]

Parts:
C13, C15, C17, C32, C33, C34, C35: 100nF 50V; C0805
C14: 1uF 16V; C0805
D1, D2, D3, D4: CDSOT23-0502B; SOT-23-3
R12, R13: 4k7; R1206
R18, R20, R21, R23, R24, R26, R27, R29: 1k; R1206
R19, R22, R25, R28: 120R; R1206
U4, U5, U6, U7: SN65HVD11DR; SOIC127P600X175-8N
U8: MAX14830ETMT; 21-0144H_T4877-3

Connections:
+3V3: C15.1, C17.1, C32.1, C33.1, C34.1, C35.1, R12.1, R13.1, R18.1, R21.1, R24.1, R27.1, U4.8 (VCC), U5.8 (VCC), U6.8 (VCC), U7.8 (VCC), U8.1 (SPI/*I2C), U8.2 (LDOEN), U8.9 (VL), U8.43 (VEXT), U8.47 (VA); also elsewhere on the board
AS312_OUT: U8.16 (*CTS0); also elsewhere on the board
CLK_12M: U8.45 (XIN); also elsewhere on the board
ESP32_IO5: U8.5 (*CS/A0); also elsewhere on the board
ESP32_IO18: U8.4 (SCLK/SCL); also elsewhere on the board
ESP32_IO19: U8.3 (MISO/SDA); also elsewhere on the board
ESP32_IO21: R13.2, U8.7 (*IRQ); also elsewhere on the board
ESP32_IO23: U8.6 (MOSI/A1); also elsewhere on the board
GND: C13.2, C14.2, C15.2, C17.2, C32.2, C33.2, C34.2, C35.2, D1.3 (GND), D2.3 (GND), D3.3 (GND), D4.3 (GND), R20.2, R23.2, R26.2, R29.2, U4.5 (GND), U5.5 (GND), U6.5 (GND), U7.5 (GND), U8.10 (DGND), U8.46 (AGND), U8.49 (EP); also elsewhere on the board
MAX_IO0: U8.11 (GPIO0); also elsewhere on the board
MAX_IO1: U8.12 (GPIO1); also elsewhere on the board
MAX_IO2: U8.13 (GPIO2); also elsewhere on the board
MAX_IO3: U8.14 (GPIO3); also elsewhere on the board
MAX_IO4: U8.19 (GPIO4); also elsewhere on the board
MAX_IO5: U8.20 (GPIO5); also elsewhere on the board
MAX_IO6: U8.21 (GPIO6); also elsewhere on the board
MAX_IO7: U8.22 (GPIO7); also elsewhere on the board
MAX_IO8: U8.27 (GPIO8); also elsewhere on the board
MAX_IO9: U8.28 (GPIO9); also elsewhere on the board
MAX_IO10: U8.29 (GPIO10); also elsewhere on the board
MAX_IO11: U8.30 (GPIO11); also elsewhere on the board
MAX_IO12: U8.35 (GPIO12); also elsewhere on the board
MAX_IO13: U8.36 (GPIO13); also elsewhere on the board
MAX_IO14: U8.37 (GPIO14); also elsewhere on the board
MAX_IO15: U8.38 (GPIO15); also elsewhere on the board
unnamed: U7.4 (D), U8.18 (TX0)
unnamed: U7.1 (R), U8.17 (RX0)
unnamed: U6.4 (D), U8.26 (TX1)
unnamed: U6.1 (R), U8.25 (RX1)
unnamed: U5.4 (D), U8.34 (TX2)
unnamed: U5.1 (R), U8.33 (RX2)
unnamed: U4.4 (D), U8.42 (TX3)
unnamed: U4.1 (R), U8.41 (RX3)
unnamed: U7.2 (~RE), U7.3 (DE), U8.15 (*RTS0)
unnamed: U6.2 (~RE), U6.3 (DE), U8.23 (*RTS1)
unnamed: C13.1, R12.2, U8.8 (*RST)
unnamed: U5.2 (~RE), U5.3 (DE), U8.31 (*RTS2)
unnamed: U4.2 (~RE), U4.3 (DE), U8.39 (*RTS3)
unnamed: C14.1, U8.48 (V18)
RS485_A0: D1.2 (IO2), R18.2, R19.1, U7.6 (A); also elsewhere on the board
RS485_A1: D2.2 (IO2), R21.2, R22.1, U6.6 (A); also elsewhere on the board
RS485_A2: D3.2 (IO2), R24.2, R25.1, U5.6 (A); also elsewhere on the board
RS485_A3: D4.2 (IO2), R27.2, R28.1, U4.6 (A); also elsewhere on the board
RS485_B0: D1.1 (IO1), R19.2, R20.1, U7.7 (B); also elsewhere on the board
RS485_B1: D2.1 (IO1), R22.2, R23.1, U6.7 (B); also elsewhere on the board
RS485_B2: D3.1 (IO1), R25.2, R26.1, U5.7 (B); also elsewhere on the board
RS485_B3: D4.1 (IO1), R28.2, R29.1, U4.7 (B); also elsewhere on the board

Notes on the sheet:
SPI TO UART
RS485

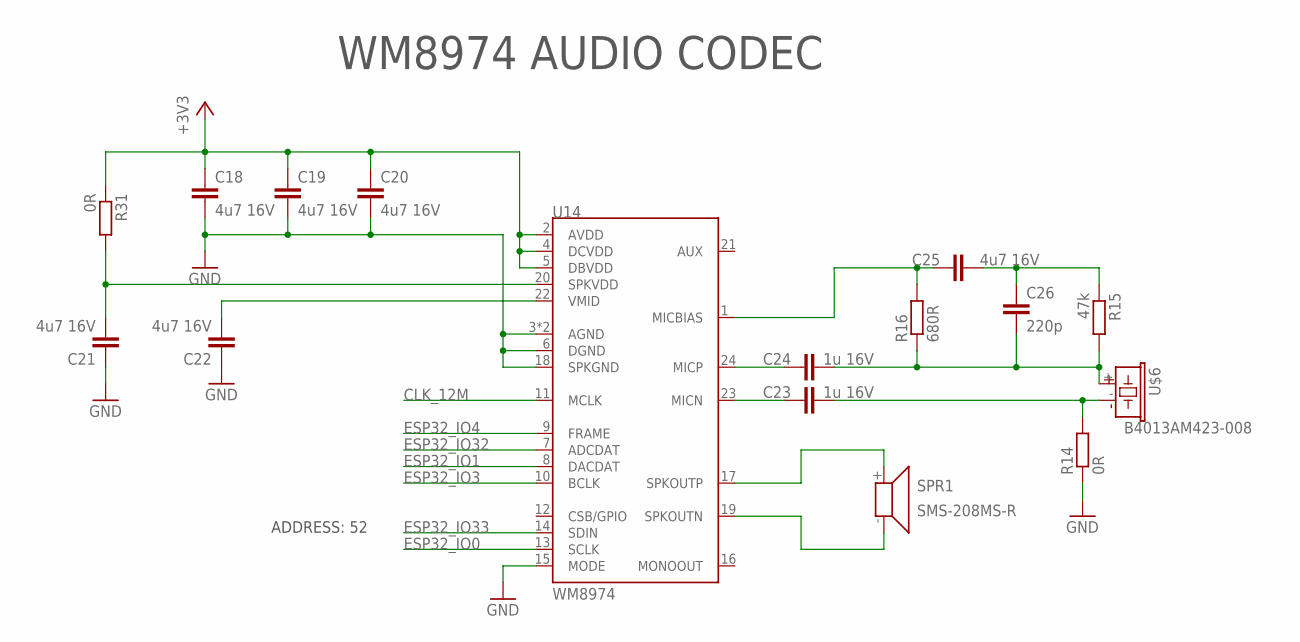
[picture p23: schematic room_sensors.sch, sheet 5]

Parts:
C18, C19, C20, C21, C22, C25: 4u7 16V; C0805
C23, C24: 1u 16V; C0805
C26: 220p; C0805
R14: 0R; R1206
R15: 47k; R1206
R16: 680R; R1206
R31: 0R; R0603
SPR1: SMS-208MS-R; SMS-2008MS-R
U14: WM8974; QFN-24_ALT2
U$6: B4013AM423-008; MIC

Connections:
+3V3: C18.1, C19.1, C20.1, R31.1, U14.2 (AVDD), U14.4 (DCVDD), U14.5 (DBVDD); also elsewhere on the board
CLK_12M: U14.11 (MCLK); also elsewhere on the board
ESP32_IO0: U14.13 (SCLK); also elsewhere on the board
ESP32_IO1: U14.8 (DACDAT); also elsewhere on the board
ESP32_IO3: U14.10 (BCLK); also elsewhere on the board
ESP32_IO4: U14.9 (FRAME); also elsewhere on the board
ESP32_IO32: U14.7 (ADCDAT); also elsewhere on the board
ESP32_IO33: U14.14 (SDIN); also elsewhere on the board
GND: C18.2, C19.2, C20.2, C21.1, C22.1, R14.1, U14.3 (AGND), U14.6 (DGND), U14.15 (MODE), U14.18 (SPKGND), U14.EP (AGND); also elsewhere on the board
unnamed: C22.2, U14.22 (VMID)
unnamed: SPR1.+ (1), U14.17 (SPKOUTP)
unnamed: SPR1.- (2), U14.19 (SPKOUTN)
unnamed: C23.2, R14.2, U$6.-
unnamed: C24.2, C26.2, R15.2, R16.1, U$6.+
unnamed: C23.1, U14.23 (MICN)
unnamed: C24.1, U14.24 (MICP)
unnamed: C25.1, R16.2, U14.1 (MICBIAS)
unnamed: C25.2, C26.1, R15.1
unnamed: C21.2, R31.2, U14.20 (SPKVDD)

Notes on the sheet:
WM8974 AUDIO CODEC
ADDRESS: 52

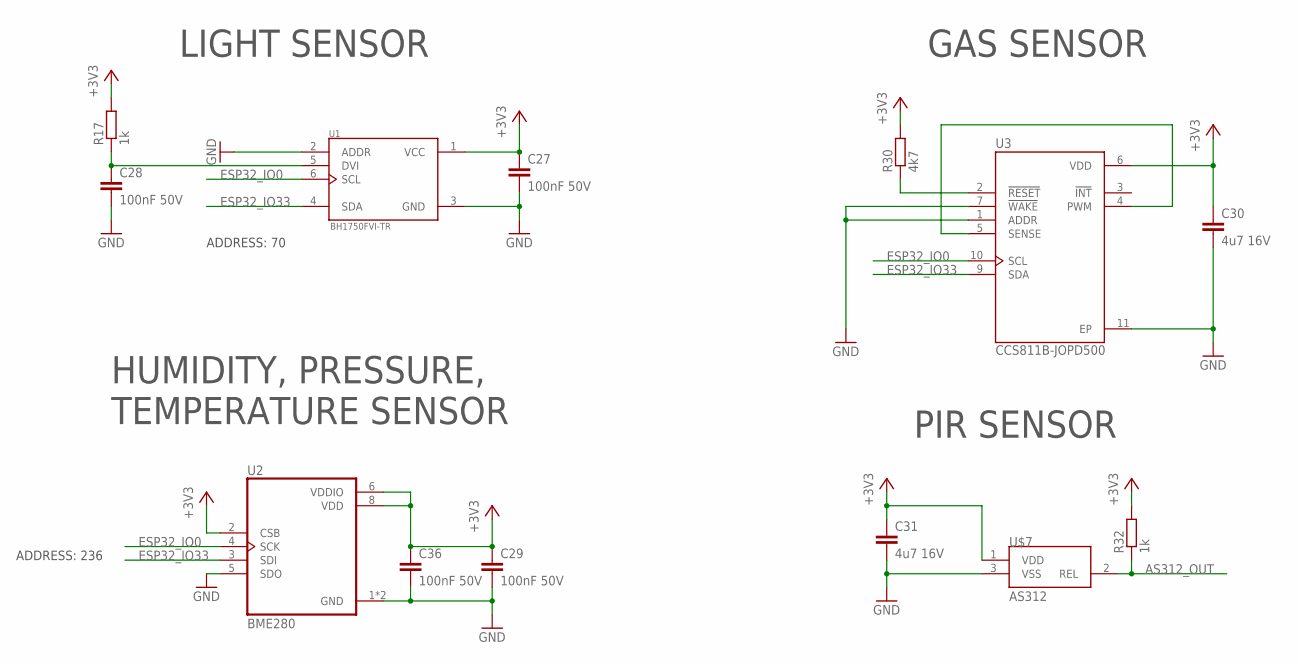
[picture p24: schematic room_sensors.sch, sheet 6]

Parts:
C27, C28, C29, C36: 100nF 50V; C0805
C30, C31: 4u7 16V; C0805
R17, R32: 1k; R1206
R30: 4k7; R1206
U1: BH1750FVI-TR; SOTFL50P300X75-6N
U2: BME280; PSON65P250X250X100-8N
U3: CCS811B-JOPD500; SON60P400X270X110-11N
U$7: AS312; TO-39

Connections:
+3V3: C27.1, C29.1, C30.1, C31.1, C36.1, R17.2, R30.2, R32.2, U1.1 (VCC), U2.2 (CSB), U2.6 (VDDIO), U2.8 (VDD), U3.6 (VDD), U$7.1 (VDD); also elsewhere on the board
AS312_OUT: R32.1, U$7.2 (REL); also elsewhere on the board
ESP32_IO0: U1.6 (SCL), U2.4 (SCK), U3.10 (SCL); also elsewhere on the board
ESP32_IO33: U1.4 (SDA), U2.3 (SDI), U3.9 (SDA); also elsewhere on the board
GND: C27.2, C28.2, C29.2, C30.2, C31.2, C36.2, U1.2 (ADDR), U1.3 (GND), U2.1 (GND), U2.5 (SDO), U2.7 (GND), U3.1 (ADDR), U3.7 (!WAKE), U3.11 (EP), U$7.3 (VSS); also elsewhere on the board
unnamed: C28.1, R17.1, U1.5 (DVI)
unnamed: U3.4 (PWM), U3.5 (SENSE)
unnamed: R30.1, U3.2 (!RESET)

Notes on the sheet:
LIGHT SENSOR
ADDRESS: 70
HUMIDITY, PRESSURE, TEMPERATURE SENSOR
ADDRESS: 236
GAS SENSOR
PIR SENSOR

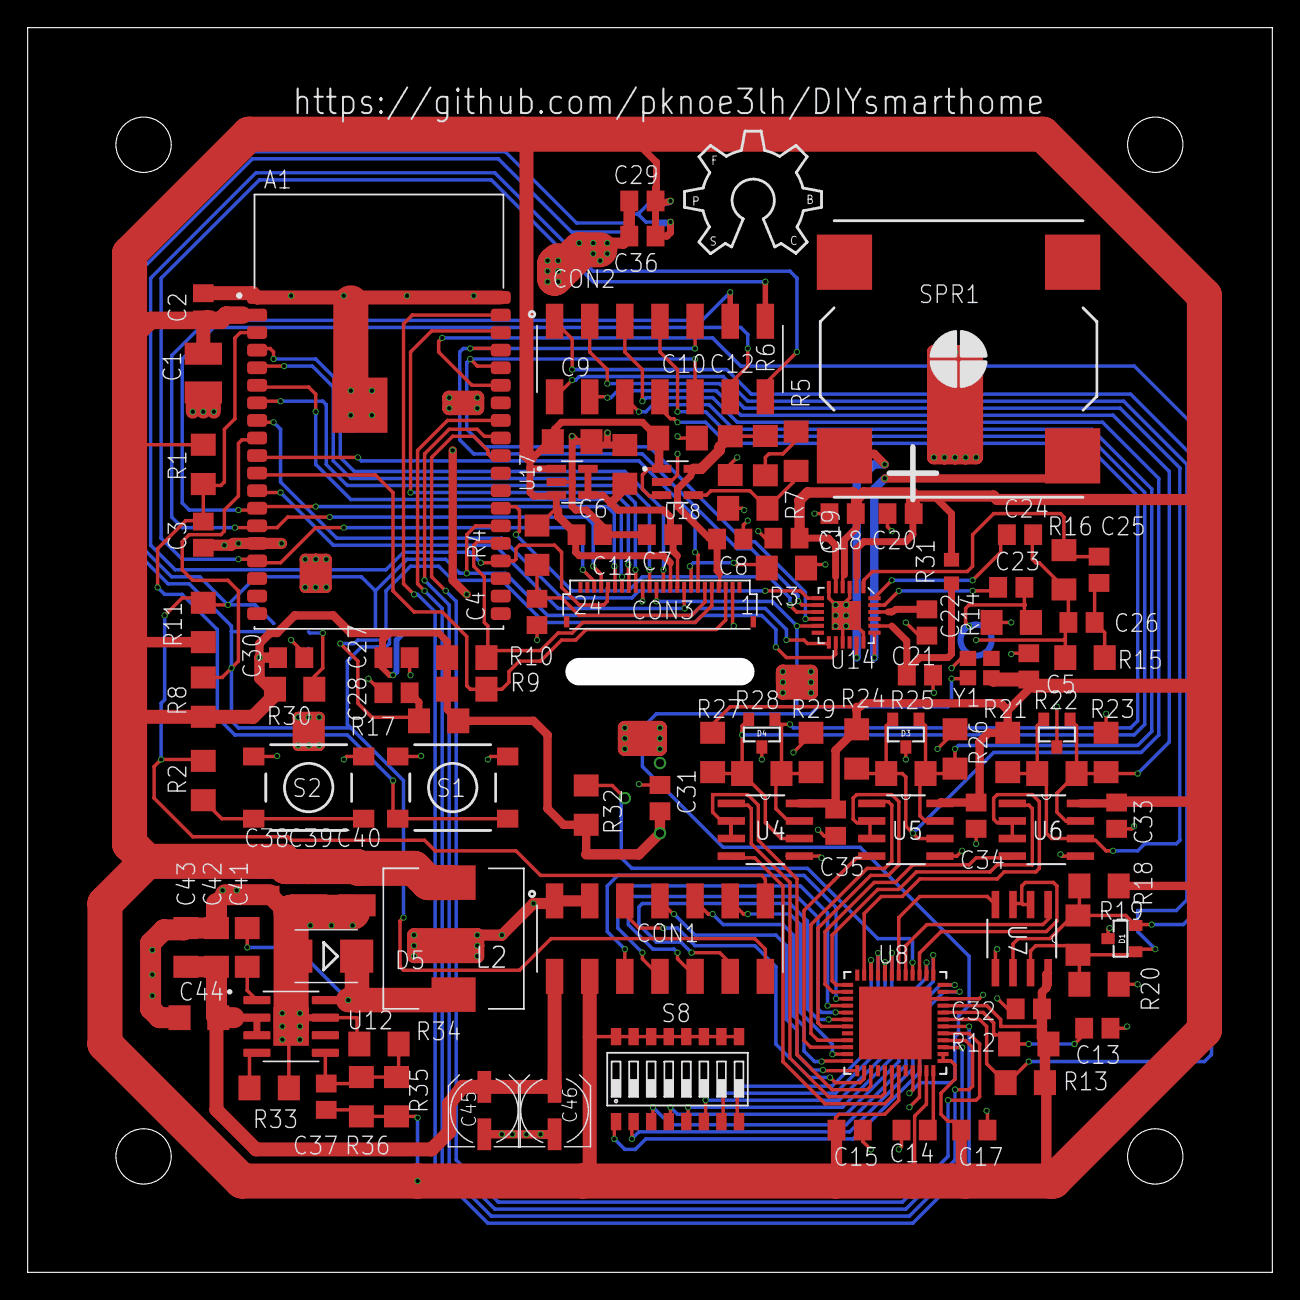
[picture p25: board room_sensors.brd from above]

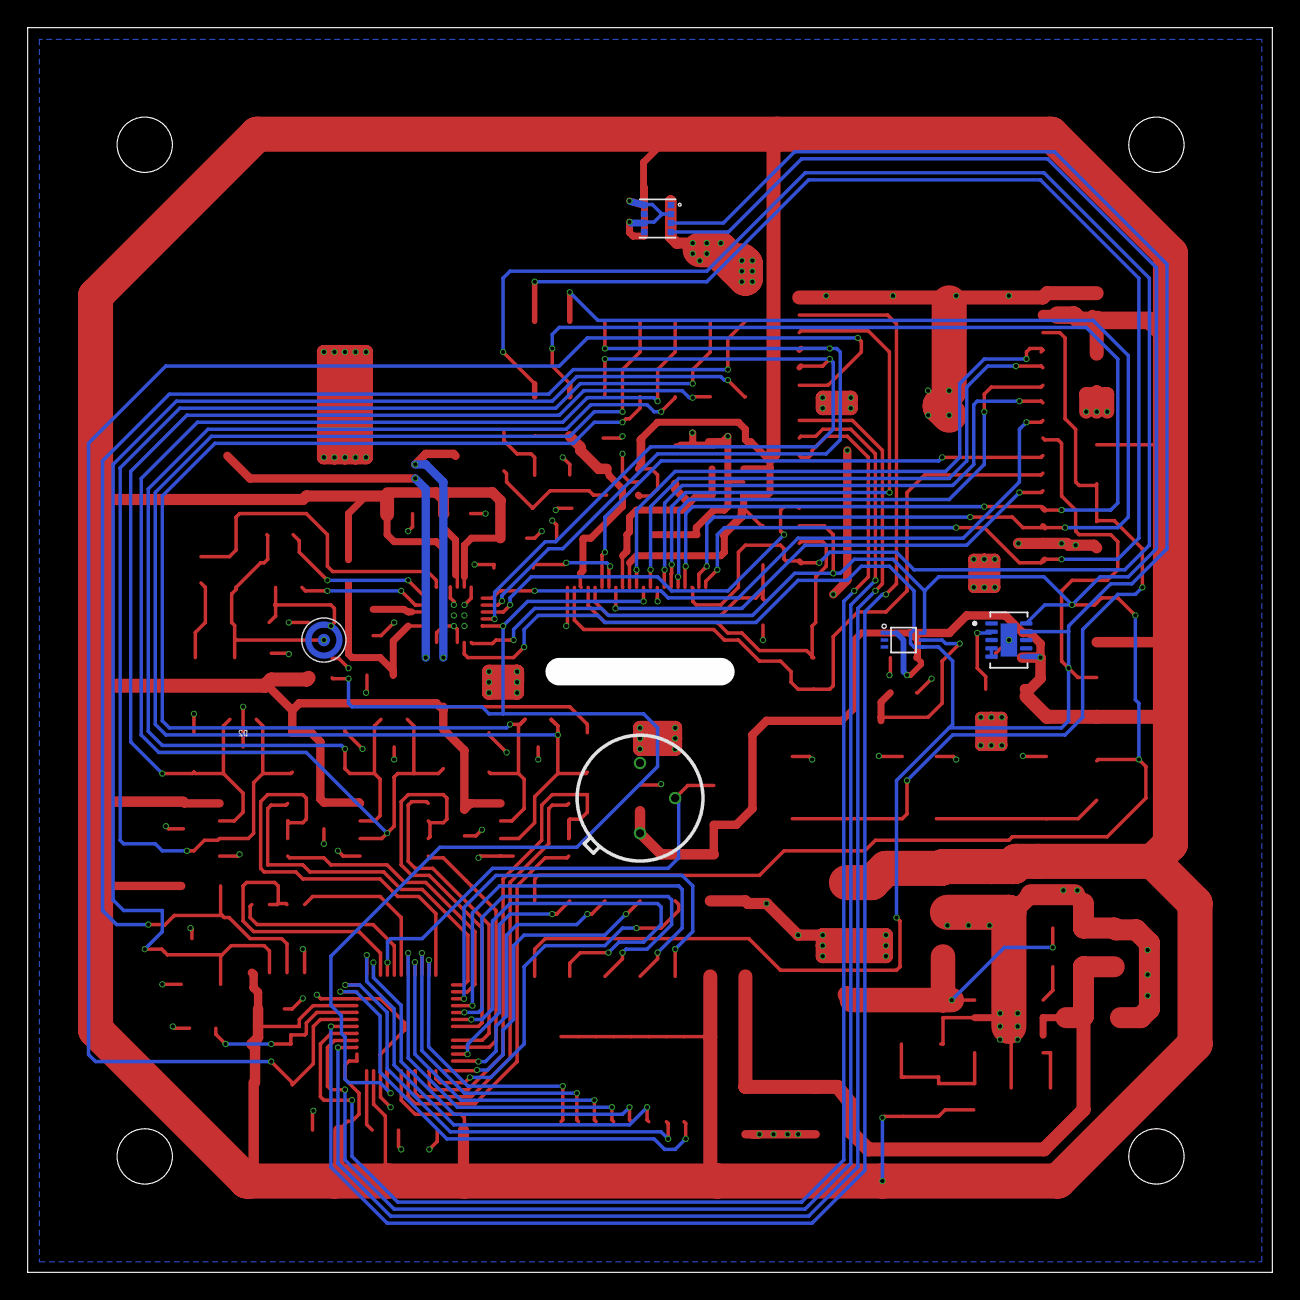
[picture p26: board room_sensors.brd from below]

Board: 2 copper layers, 90.0 x 90.0 mm, 111 parts (5 on the bottom side), 92 nets.
