im-pro-at/DIYsmarthome/PCB/order/19.04.24/room_interface.brd

## EAGLE design PCB/order/19.04.24/room_interface.brd (2019-04-26)

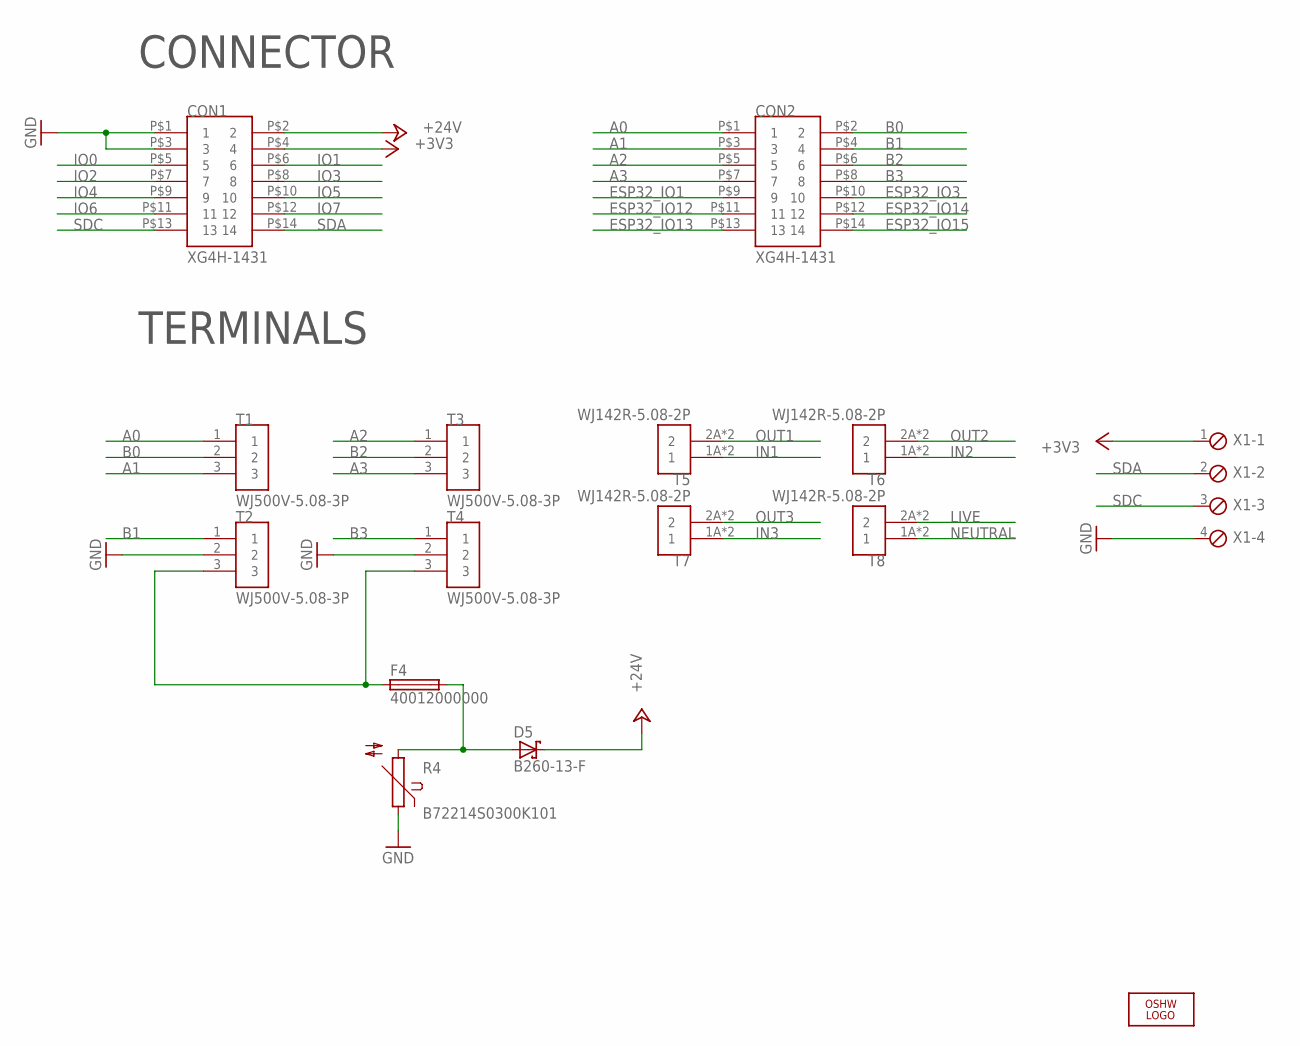
[picture p27: schematic room_interface.sch, sheet 1]

Parts:
CON1, CON2: XG4H-1431
D5: B260-13-F; SMB
F4: 40012000000; 400
LOGO1: OSHW_LOGO_FILLX0350-NT; OSHW_FILLX350_NOTEXT
R4: B72214S0300K101; S14K300
T1, T2, T3, T4: WJ500V-5.08-3P
T5, T6, T7, T8: WJ142R-5.08-2P; WJ142R.5.08-2P
X1: MPT4; 4POL254

Connections:
+3V3: CON1.P$4 (4), X1.1; also elsewhere on the board
+24V: CON1.P$2 (2), D5.C; also elsewhere on the board
A0: CON2.P$1 (1), T1.1
A1: CON2.P$3 (3), T1.3
A2: CON2.P$5 (5), T3.1
A3: CON2.P$7 (7), T3.3
B0: CON2.P$2 (2), T1.2
B1: CON2.P$4 (4), T2.1
B2: CON2.P$6 (6), T3.2
B3: CON2.P$8 (8), T4.1
ESP32_IO1: CON2.P$9 (9)
ESP32_IO3: CON2.P$10 (10)
ESP32_IO12: CON2.P$11 (11)
ESP32_IO13: CON2.P$13 (13)
ESP32_IO14: CON2.P$12 (12)
ESP32_IO15: CON2.P$14 (14)
GND: CON1.P$1 (1), CON1.P$3 (3), R4.1, T2.2, T4.2, X1.4; also elsewhere on the board
IN1: T5.1A (1), T5.1B (1); also elsewhere on the board
IN2: T6.1A (1), T6.1B (1); also elsewhere on the board
IN3: T7.1A (1), T7.1B (1); also elsewhere on the board
IO0: CON1.P$5 (5); also elsewhere on the board
IO1: CON1.P$6 (6); also elsewhere on the board
IO2: CON1.P$7 (7); also elsewhere on the board
IO3: CON1.P$8 (8)
IO4: CON1.P$9 (9)
IO5: CON1.P$10 (10); also elsewhere on the board
IO6: CON1.P$11 (11); also elsewhere on the board
IO7: CON1.P$12 (12); also elsewhere on the board
LIVE: T8.2A (2), T8.2B (2); also elsewhere on the board
unnamed: D5.A, F4.P$2 (2), R4.2
unnamed: F4.P$1 (1), T2.3, T4.3
NEUTRAL: T8.1A (1), T8.1B (1); also elsewhere on the board
OUT1: T5.2A (2), T5.2B (2); also elsewhere on the board
OUT2: T6.2A (2), T6.2B (2); also elsewhere on the board
OUT3: T7.2A (2), T7.2B (2); also elsewhere on the board
SDA: CON1.P$14 (14), X1.2
SDC: CON1.P$13 (13), X1.3

Notes on the sheet:
CONNECTOR
TERMINALS

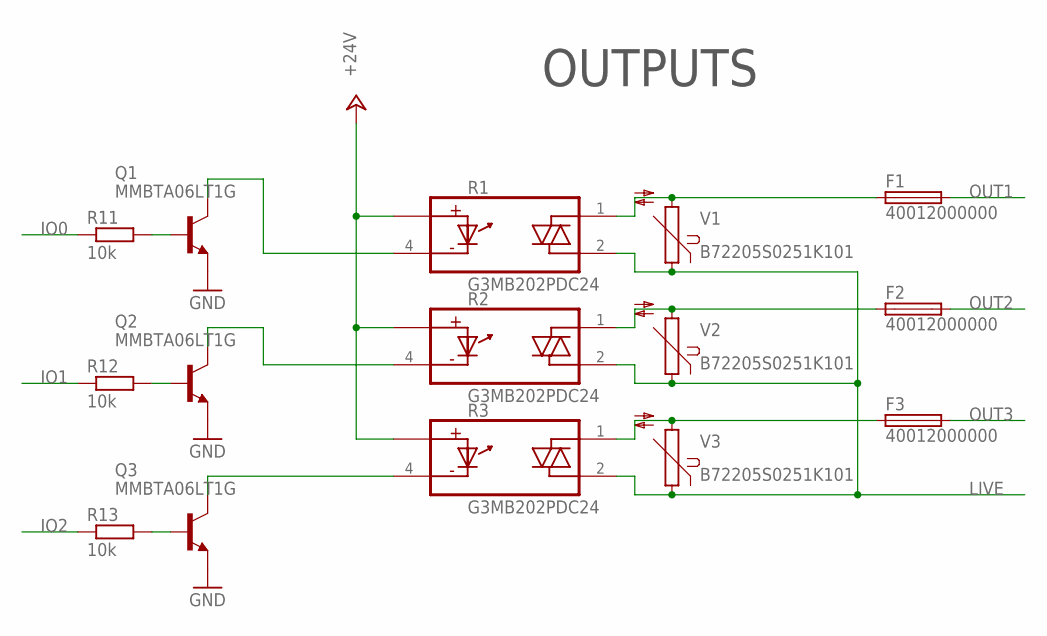
[picture p28: schematic room_interface.sch, sheet 2]

Parts:
F1, F2, F3: 40012000000; 400
Q1, Q2, Q3: MMBTA06LT1G; SOT23-BEC
R1, R2, R3: G3MB202PDC24; RELAY_G3MB202PDC12
R11, R12, R13: 10k; R1206
V1, V2, V3: B72205S0251K101; S05K250

Connections:
+24V: R1.3 (IN+), R2.3 (IN+), R3.3 (IN+); also elsewhere on the board
GND: Q1.E, Q2.E, Q3.E; also elsewhere on the board
IO0: R11.1; also elsewhere on the board
IO1: R12.1; also elsewhere on the board
IO2: R13.1; also elsewhere on the board
LIVE: R1.2 (OUT2), R2.2 (OUT2), R3.2 (OUT2), V1.1, V2.1, V3.1; also elsewhere on the board
unnamed: F1.P$1 (1), R1.1 (OUT1), V1.2
unnamed: F2.P$1 (1), R2.1 (OUT1), V2.2
unnamed: F3.P$1 (1), R3.1 (OUT1), V3.2
unnamed: Q1.B, R11.2
unnamed: Q1.C, R1.4 (IN-)
unnamed: Q2.B, R12.2
unnamed: Q2.C, R2.4 (IN-)
unnamed: Q3.B, R13.2
unnamed: Q3.C, R3.4 (IN-)
OUT1: F1.P$2 (2); also elsewhere on the board
OUT2: F2.P$2 (2); also elsewhere on the board
OUT3: F3.P$2 (2); also elsewhere on the board

Notes on the sheet:
OUTPUTS

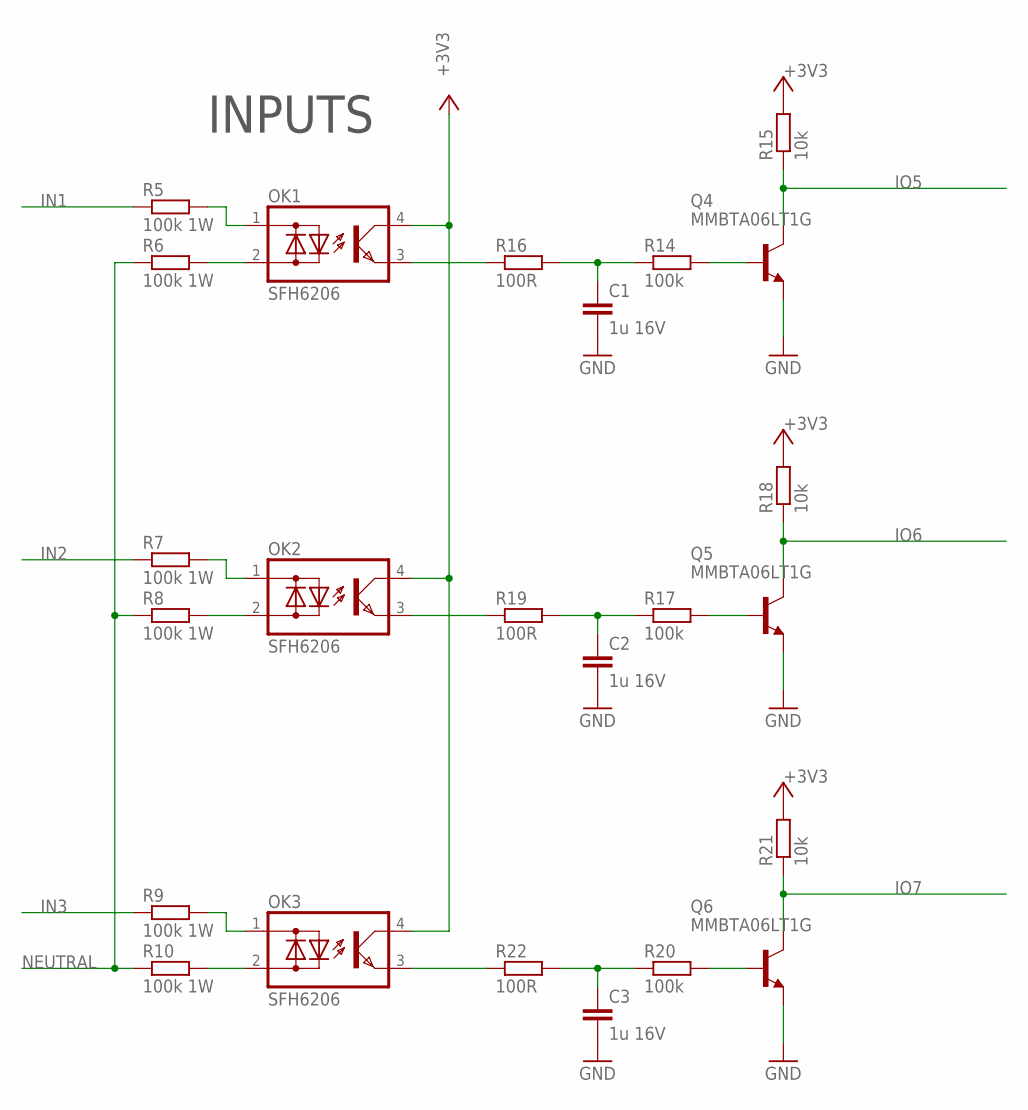
[picture p29: schematic room_interface.sch, sheet 3]

Parts:
C1, C2, C3: 1u 16V; C0805
OK1, OK2, OK3: SFH6206; DIL4-SMD
Q4, Q5, Q6: MMBTA06LT1G; SOT23-BEC
R5, R6, R7, R8, R9, R10: 100k 1W; R2010
R14, R17, R20: 100k; R1206
R15, R18, R21: 10k; R1206
R16, R19, R22: 100R; R1206

Connections:
+3V3: OK1.4 (C), OK2.4 (C), OK3.4 (C), R15.2, R18.2, R21.2; also elsewhere on the board
GND: C1.2, C2.2, C3.2, Q4.E, Q5.E, Q6.E; also elsewhere on the board
IN1: R5.1; also elsewhere on the board
IN2: R7.1; also elsewhere on the board
IN3: R9.1; also elsewhere on the board
IO5: Q4.C, R15.1; also elsewhere on the board
IO6: Q5.C, R18.1; also elsewhere on the board
IO7: Q6.C, R21.1; also elsewhere on the board
unnamed: OK1.2 (AC2), R6.2
unnamed: OK1.1 (AC1), R5.2
unnamed: OK2.1 (AC1), R7.2
unnamed: OK2.2 (AC2), R8.2
unnamed: OK3.1 (AC1), R9.2
unnamed: OK3.2 (AC2), R10.2
unnamed: Q4.B, R14.2
unnamed: OK1.3 (E), R16.1
unnamed: C1.1, R14.1, R16.2
unnamed: Q5.B, R17.2
unnamed: OK2.3 (E), R19.1
unnamed: C2.1, R17.1, R19.2
unnamed: Q6.B, R20.2
unnamed: OK3.3 (E), R22.1
unnamed: C3.1, R20.1, R22.2
NEUTRAL: R6.1, R8.1, R10.1; also elsewhere on the board

Notes on the sheet:
INPUTS
