im-pro-at/DIYsmarthome/PCB/order/19.04.24/room_interface.brd

## EAGLE design PCB/order/19.04.24/room_interface.brd (continued)

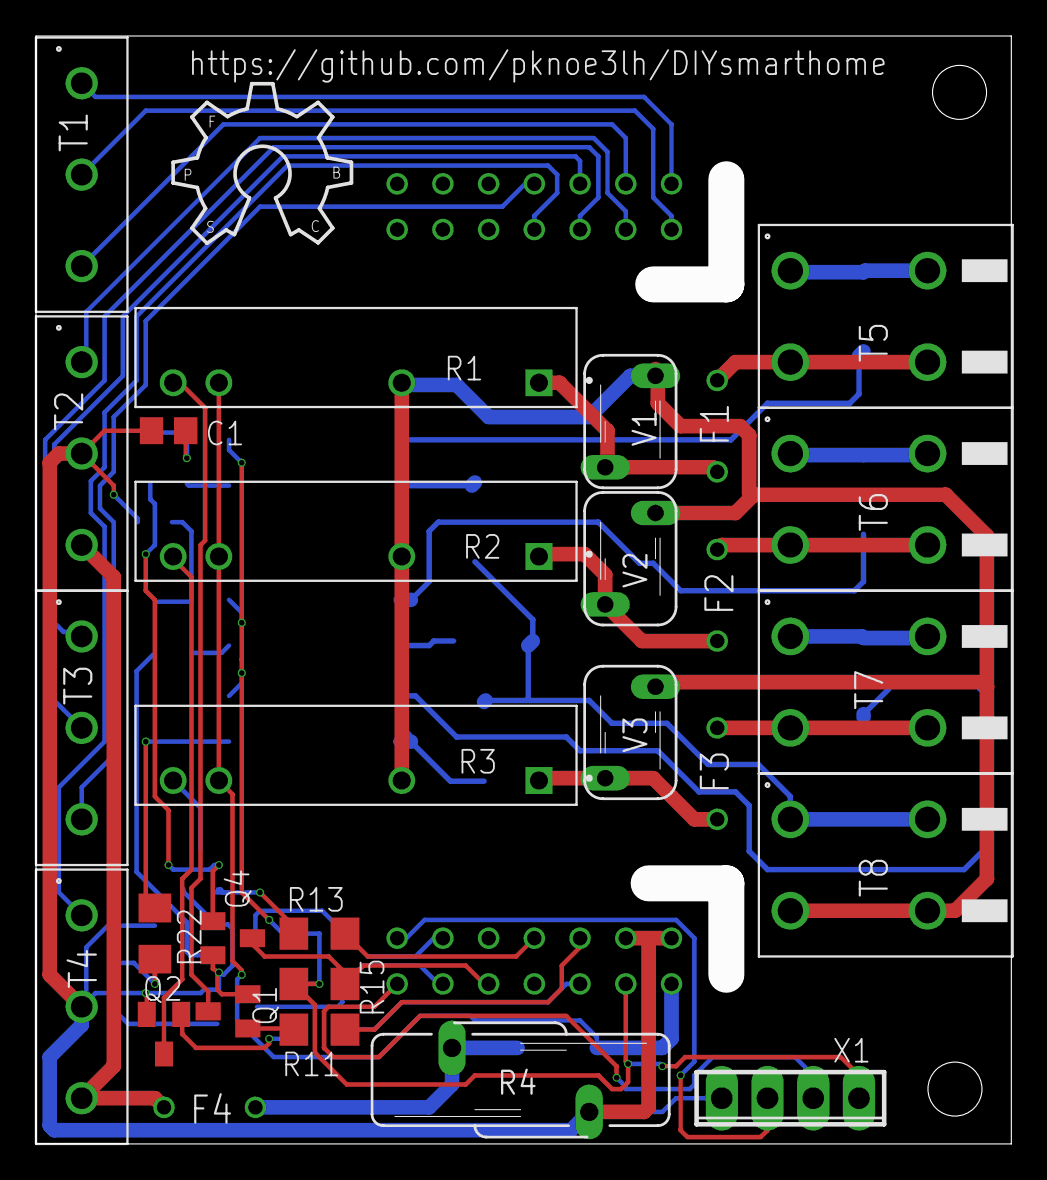
[picture p30: board room_interface.brd from above]

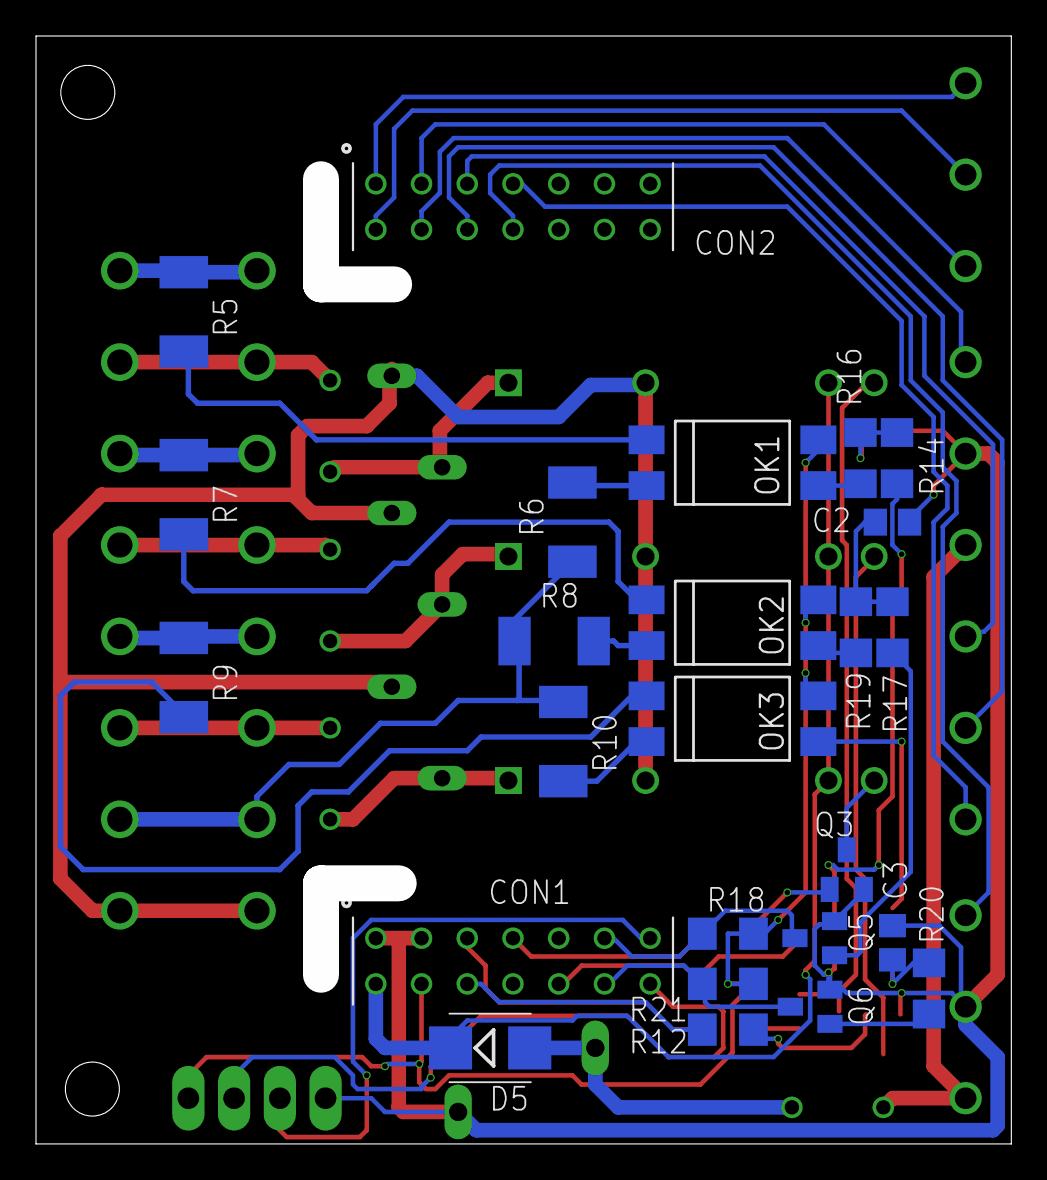
[picture p31: board room_interface.brd from below]

Board: 2 copper layers, 54.2 x 61.6 mm, 54 parts (25 on the bottom side), 53 nets.
