im-pro-at/DIYsmarthome/PCB/order/19.04.24/master.brd

## EAGLE design PCB/order/19.04.24/master.brd (2019-04-26)

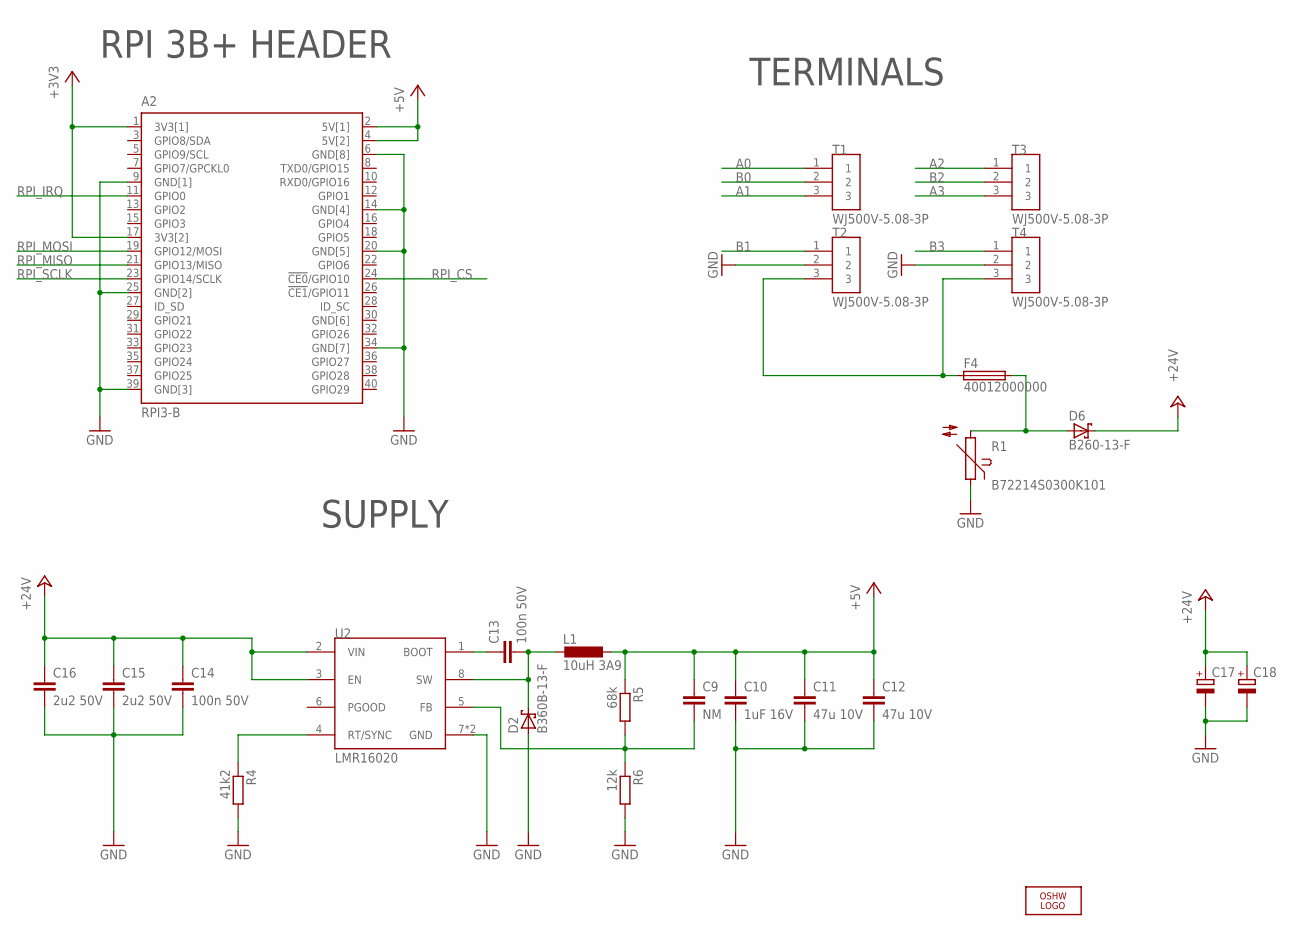
[picture p32: schematic master.sch, sheet 1]

Parts:
A2: RPI3-B
C9: NM; C0805
C10: 1uF 16V; C0805
C11, C12: 47u 10V; C1210
C13, C14: 100n 50V; C1206
C15, C16: 2u2 50V; C1206
C17, C18: CPOL-EUUD-5X5,8; UD-5X5,8_NICHICON
D2: B360B-13-F; SMB
D6: B260-13-F; SMB
F4: 40012000000; 400
L1: 10uH 3A9; 1217AS
LOGO1: OSHW_LOGO_FILLX0350-NT; OSHW_FILLX350_NOTEXT
R1: B72214S0300K101; S14K300
R4: 41k2; R1206
R5: 68k; R1206
R6: 12k; R1206
T1, T2, T3, T4: WJ500V-5.08-3P
U2: LMR16020; SOIC127P600X170-8N

Connections:
+3V3: A2.1 (3V3[1]), A2.17 (3V3[2]); also elsewhere on the board
+5V: A2.2 (5V[1]), A2.4 (5V[2]), C9.1, C10.1, C11.1, C12.1, L1.1, R5.1
+24V: C14.1, C15.1, C16.1, C17.+, C18.+, D6.C, U2.2 (VIN), U2.3 (EN)
A0: T1.1; also elsewhere on the board
A1: T1.3; also elsewhere on the board
A2: T3.1; also elsewhere on the board
A3: T3.3; also elsewhere on the board
B0: T1.2; also elsewhere on the board
B1: T2.1; also elsewhere on the board
B2: T3.2; also elsewhere on the board
B3: T4.1; also elsewhere on the board
GND: A2.6 (GND[8]), A2.9 (GND[1]), A2.14 (GND[4]), A2.20 (GND[5]), A2.25 (GND[2]), A2.34 (GND[7]), A2.39 (GND[3]), C10.2, C11.2, C12.2, C14.2, C15.2, C16.2, C17.-, C18.-, D2.A, R1.1, R4.2, R6.2, T2.2, T4.2, U2.7 (GND), U2.9 (GND); also elsewhere on the board
GND[6]: A2.30 (GND[6])
unnamed: R4.1, U2.4 (RT/SYNC)
unnamed: C9.2, R5.2, R6.1, U2.5 (FB)
unnamed: C13.2, D2.C, L1.2, U2.8 (SW)
unnamed: C13.1, U2.1 (BOOT)
unnamed: F4.P$1 (1), T2.3, T4.3
unnamed: D6.A, F4.P$2 (2), R1.2
RPI_CS: A2.24 (!CE0!/GPIO10); also elsewhere on the board
RPI_IRQ: A2.11 (GPIO0); also elsewhere on the board
RPI_MISO: A2.21 (GPIO13/MISO); also elsewhere on the board
RPI_MOSI: A2.19 (GPIO12/MOSI); also elsewhere on the board
RPI_SCLK: A2.23 (GPIO14/SCLK); also elsewhere on the board

Notes on the sheet:
SUPPLY
RPI 3B+ HEADER
TERMINALS

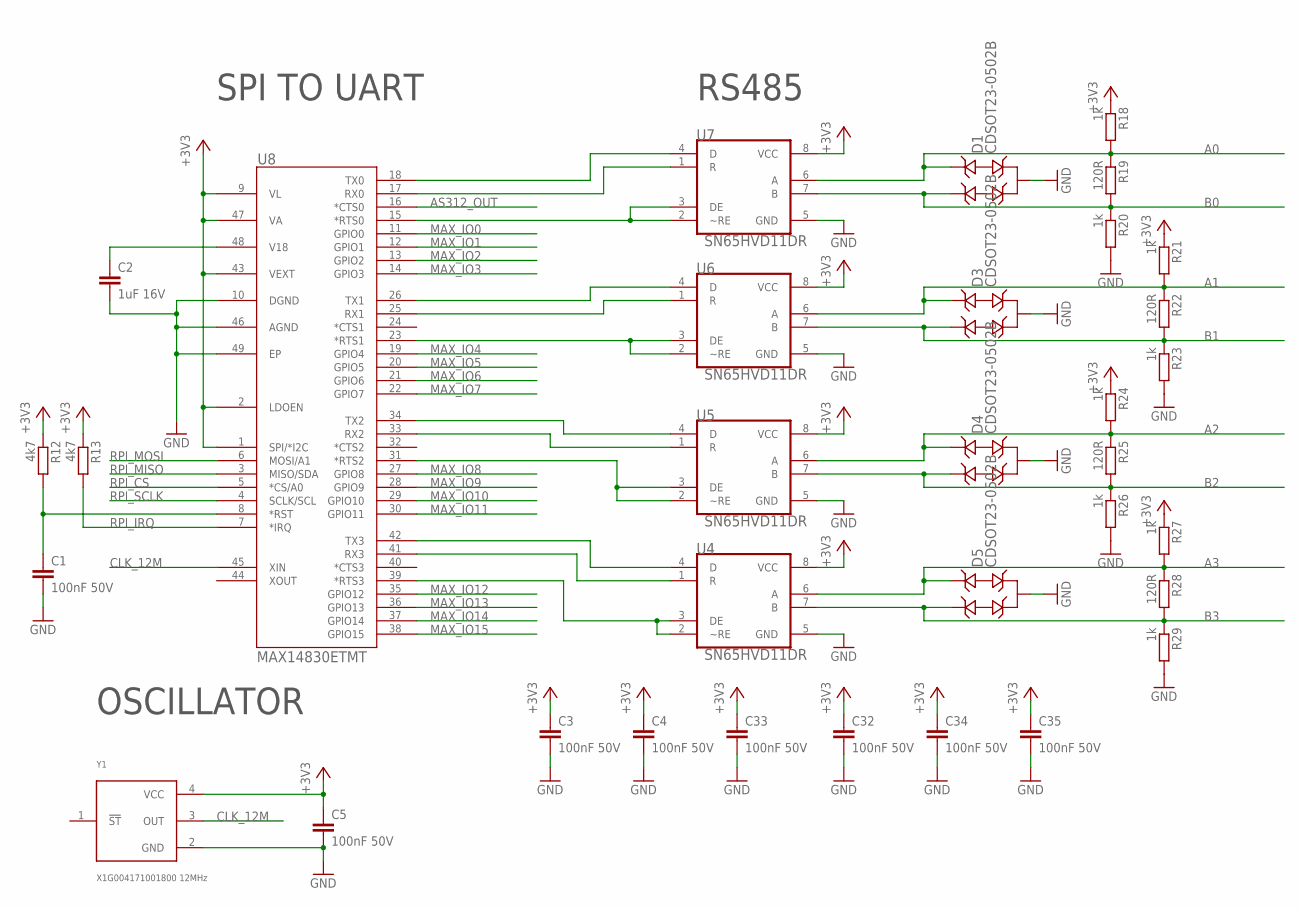
[picture p33: schematic master.sch, sheet 2]

Parts:
C1, C3, C4, C5, C32, C33, C34, C35: 100nF 50V; C0805
C2: 1uF 16V; C0805
D1, D3, D4, D5: CDSOT23-0502B; SOT-23-3
R12, R13: 4k7; R1206
R18, R20, R21, R23, R24, R26, R27, R29: 1k; R1206
R19, R22, R25, R28: 120R; R1206
U4, U5, U6, U7: SN65HVD11DR; SOIC127P600X175-8N
U8: MAX14830ETMT; 21-0144H_T4877-3
Y1: X1G004171001800 12MHz; OSCCC250X200X80-4N

Connections:
+3V3: C3.1, C4.1, C5.1, C32.1, C33.1, C34.1, C35.1, R12.1, R13.1, R18.1, R21.1, R24.1, R27.1, U4.8 (VCC), U5.8 (VCC), U6.8 (VCC), U7.8 (VCC), U8.1 (SPI/*I2C), U8.2 (LDOEN), U8.9 (VL), U8.43 (VEXT), U8.47 (VA), Y1.4 (VCC); also elsewhere on the board
A0: D1.2 (IO2), R18.2, R19.1, U7.6 (A); also elsewhere on the board
A1: D3.2 (IO2), R21.2, R22.1, U6.6 (A); also elsewhere on the board
A2: D4.2 (IO2), R24.2, R25.1, U5.6 (A); also elsewhere on the board
A3: D5.2 (IO2), R27.2, R28.1, U4.6 (A); also elsewhere on the board
AS312_OUT: U8.16 (*CTS0)
B0: D1.1 (IO1), R19.2, R20.1, U7.7 (B); also elsewhere on the board
B1: D3.1 (IO1), R22.2, R23.1, U6.7 (B); also elsewhere on the board
B2: D4.1 (IO1), R25.2, R26.1, U5.7 (B); also elsewhere on the board
B3: D5.1 (IO1), R28.2, R29.1, U4.7 (B); also elsewhere on the board
CLK_12M: U8.45 (XIN), Y1.3 (OUT)
GND: C1.2, C2.2, C3.2, C4.2, C5.2, C32.2, C33.2, C34.2, C35.2, D1.3 (GND), D3.3 (GND), D4.3 (GND), D5.3 (GND), R20.2, R23.2, R26.2, R29.2, U4.5 (GND), U5.5 (GND), U6.5 (GND), U7.5 (GND), U8.10 (DGND), U8.46 (AGND), U8.49 (EP), Y1.2 (GND); also elsewhere on the board
MAX_IO0: U8.11 (GPIO0)
MAX_IO1: U8.12 (GPIO1)
MAX_IO2: U8.13 (GPIO2)
MAX_IO3: U8.14 (GPIO3)
MAX_IO4: U8.19 (GPIO4)
MAX_IO5: U8.20 (GPIO5)
MAX_IO6: U8.21 (GPIO6)
MAX_IO7: U8.22 (GPIO7)
MAX_IO8: U8.27 (GPIO8)
MAX_IO9: U8.28 (GPIO9)
MAX_IO10: U8.29 (GPIO10)
MAX_IO11: U8.30 (GPIO11)
MAX_IO12: U8.35 (GPIO12)
MAX_IO13: U8.36 (GPIO13)
MAX_IO14: U8.37 (GPIO14)
MAX_IO15: U8.38 (GPIO15)
unnamed: U6.1 (R), U8.25 (RX1)
unnamed: U5.4 (D), U8.34 (TX2)
unnamed: U7.4 (D), U8.18 (TX0)
unnamed: U5.1 (R), U8.33 (RX2)
unnamed: U7.1 (R), U8.17 (RX0)
unnamed: U6.4 (D), U8.26 (TX1)
unnamed: U4.4 (D), U8.42 (TX3)
unnamed: U4.1 (R), U8.41 (RX3)
unnamed: U7.2 (~RE), U7.3 (DE), U8.15 (*RTS0)
unnamed: U6.2 (~RE), U6.3 (DE), U8.23 (*RTS1)
unnamed: U5.2 (~RE), U5.3 (DE), U8.31 (*RTS2)
unnamed: U4.2 (~RE), U4.3 (DE), U8.39 (*RTS3)
unnamed: C1.1, R12.2, U8.8 (*RST)
unnamed: C2.1, U8.48 (V18)
RPI_CS: U8.5 (*CS/A0); also elsewhere on the board
RPI_IRQ: R13.2, U8.7 (*IRQ); also elsewhere on the board
RPI_MISO: U8.3 (MISO/SDA); also elsewhere on the board
RPI_MOSI: U8.6 (MOSI/A1); also elsewhere on the board
RPI_SCLK: U8.4 (SCLK/SCL); also elsewhere on the board

Notes on the sheet:
SPI TO UART
RS485
OSCILLATOR

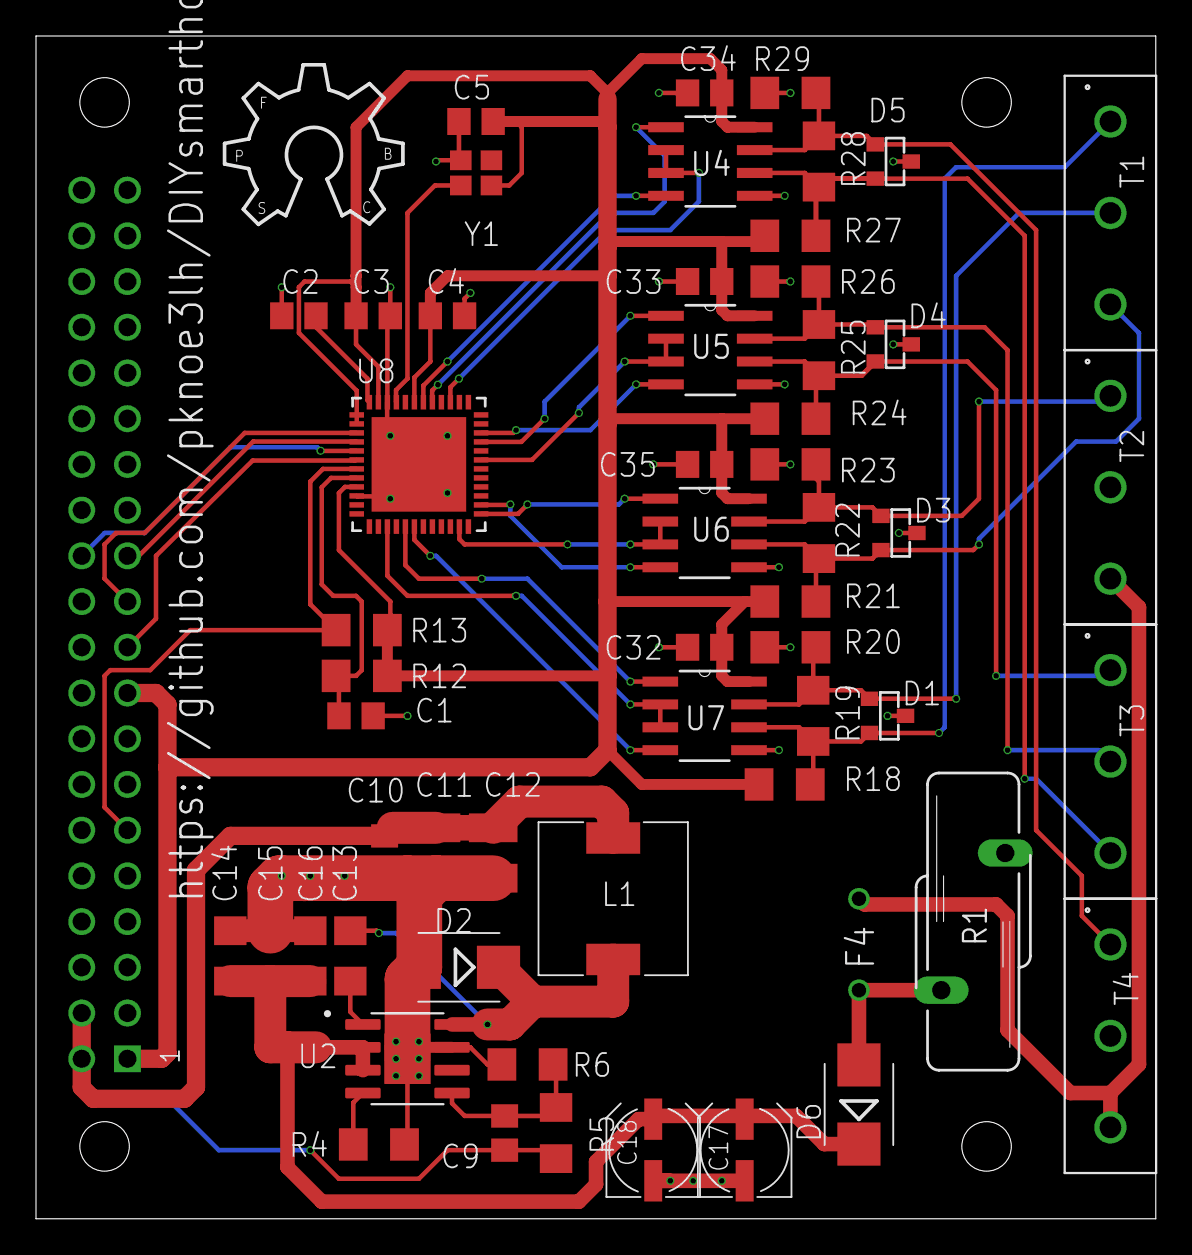
[picture p34: board master.brd from above]

Board: 2 copper layers, 62.2 x 65.7 mm, 58 parts (0 on the bottom side), 38 nets.
