im-pro-at/DIYsmarthome/(commit log)

2019-04-17 start of PCB desigen
    [room_interface.sch, room_sensors.brd, room_sensors.sch]
2019-04-19 first version of schematic ready
    [room_sensors.brd, room_sensors.sch]
2019-04-19 Placement done
    [room_sensors.brd, room_sensors.sch]
2019-04-21 finished routing for room sensor PCB
    [room_interface.sch, room_sensors.brd, room_sensors.sch]
2019-04-22 finished interface PCB
    [master.sch, room_interface.brd, room_interface.sch, room_sensors.brd, room_sensors.sch]
2019-04-23 finished PCB designs
    [master.brd, master.sch, room_interface.brd, room_interface.sch, room_sensors.brd]
2019-04-26 PCB ordered
    [master.brd, master.sch, room_interface.brd, room_interface.sch, room_sensors.brd, room_sensors.sch]
